Logan-Shi/Teleop-Hand/README.md

# Teleop-Hand
Designer and Manufacture 2 project
