Logan-Shi/Teleop-Hand/paper/README.md

### 指节自适应，弹簧+线驱动:   
> H. Luo, X. Duan and H. Deng, "Sliding mode impedance control of a underactuated prosthetic hand," 2014 IEEE International Conference on Information and Automation (ICIA), Hailar, 2014, pp. 726-729.

### 指节自适应，连杆:  
> J. Zhao, L. Jiang, S. Shi, H. Cai, H. Liu and G. Hirzinger, "A Five-fingered Underactuated Prosthetic Hand System," 2006 International Conference on Mechatronics and Automation, Luoyang, Henan, 2006, pp. 1453-1458.

### actuation有点复杂，不确定怎么实现的自适应，弹簧+线驱动:
> T. E. Wiste, S. A. Dalley, T. J. Withrow and M. Goldfarb, "Design of a multifunctional anthropomorphic prosthetic hand with extrinsic actuation," 2009 IEEE International Conference on Rehabilitation Robotics, Kyoto, 2009, pp. 675-681.

### RTR，手指间自适应，线驱动，具体机械结构没给，看上去用了齿轮:  
> Dario, Paolo & Carrozza, M & Menciassi, A & Micera, Silvestro & Zecca, Massimiliano & Cappiello, G & Sebastiani, F & Freschi, Cinzia & Scuola, Superiore & anna, Polo & Sant, & Viale, Anna & Piaggio, Rinaldo. (2019). On the development of a cybernetic hand prosthesis.
