Logan-Shi/Teleop-Hand/Meeting record.md

# 设计与制造会议记录 
#会议记录
## 2019.09.16
* 提出设计思路
> 垃圾分拣  
> 无人驾驶  
> 车辆底盘悬挂  
## 2019.09.23
* 继续讨论开题内容
> 垃圾分拣  
> 	通过深度神经网络识别垃圾类型，通过机械手分拣  
> 机械手  
> 	仿生机械手，通过rgbd相机识别对象手势，进行模拟和行为  
> 全地形车辆  
> 	利用可变形车轮实现全地形移动  
> 基于球形关节的三维建模设备	  
> 	实现难度集中在算法  
## 2019.10.08
> 确定项目工作场景：分拣抓取  
> 确定大致机械结构：  
> 	三指机械手，圆形手掌，其中一指根部固定，另外两指能够移动到固定/任意位置。即三指120º夹角或一指与另外两指180º夹角，来应对不同物体的抓取。  
> 当前工作重点：  
> 	**继续深入市场调研**  
> 		已有的材料是：目前大多数厂家应对机械臂抓取时采用的方案是，在应对	不同抓取场景时，更换不同的手指（类似于换刀）。  
> 	暂定可行的解释方案：  
> 		提高抓取效率  
> 	**机械结构设计**  
> 	两种手指位置转换时，手指根部的固定  
> 	单个手指的开合  
> 提出的可行扩展方案：  
> 	**加入自适应抓取手指结构**  
> 		可能可以借鉴螺旋测微器末端的机械结构，当单个指节遇到阻碍时，利用		棘轮停止该关节的继续转动，保护关节。同时设计某种传动机构，实现卡		住上一个关节的同时，继续操控下一关节  
> 将来可能要注意的事情：  
> 	**标准件的选取**  
> 		可以降低设计成本、便于更换  
> 当前分工：  
> 	石子康：应用场景的深入调研  
> 	隋思哲 董仕豪：手指根部位置转换和固定的机构调研和设计  
> 	梁锐彬 陈锦辉：手指开合关节的设计  
>    
> 目前已完成工作：  
> 视觉部分：  
> 	已经找到可用的手势识别api，可以识别各个关节对应的角度
