Logan-Shi/Teleop-Hand/机械手3.9.4_Szk_even_more装配裕量/手指2.1/零件清单.xlsx

名称 | 数量 | 制作方式
根指节 | 3 | 3D打印
尾指节 | 3 | 3D打印
拇指跟 | 1 | 3D打印
手指跟 | 2 | 3D打印
顶盖走线 | 1 | 3D打印
钢轴phi3 | 3 | 购买
钢轴phi5 | 3 | 购买
推力轴承5*12*4 | 6 | 购买
轴承3*7*3 | 12 | 购买
轴承2*5*2.5 | 2 | 购买
扭簧 | 3 | 购买
拉伸弹簧 | 3 | 购买
