Logan-Shi/Teleop-Hand/机械手3.9.4_Szk_even_more装配裕量/底座/block_b3.SLDASM

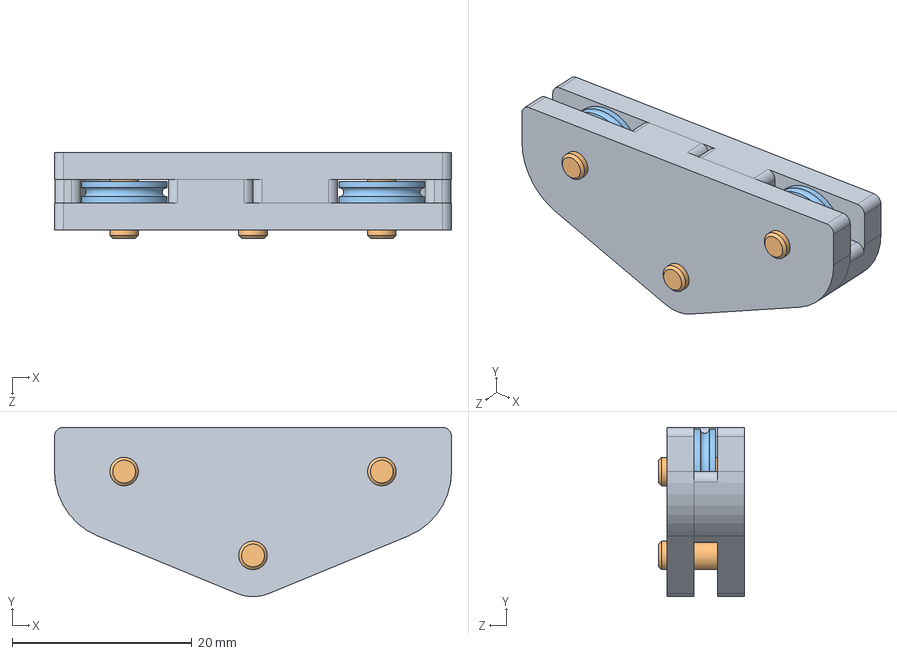
[picture p20: CAD file, 2019-12-19]
机械手3.9.4_Szk_even_more装配裕量/底座/block_b3.SLDASM
44.2 x 18.9 x 9.53 mm
b3_t x 2
97395A435 D1-8 L3-8 x 3
3434T31 - nylon pulley x 2
