Logan-Shi/Teleop-Hand/机械手3.9.4_Szk_even_more装配裕量/手指2.1/手指.SLDASM

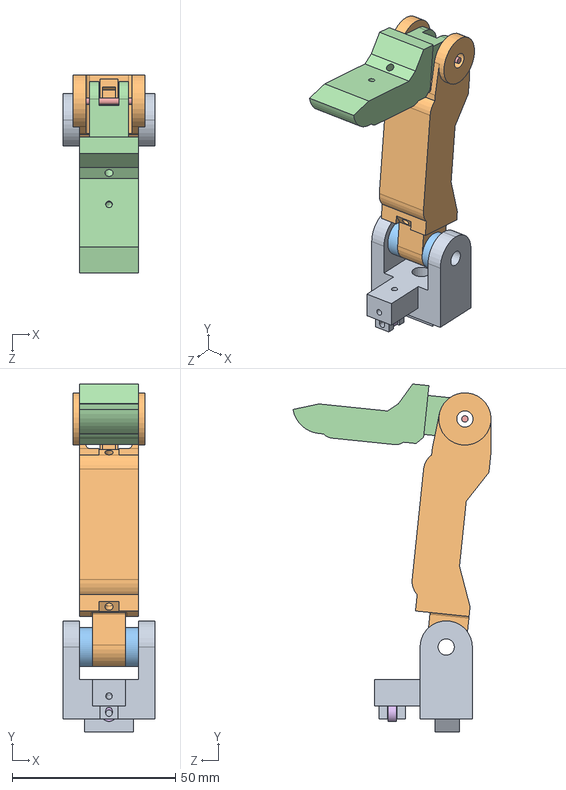
[picture p21: CAD file, 2019-12-19]
机械手3.9.4_Szk_even_more装配裕量/手指2.1/手指.SLDASM
28.0 x 106.5 x 60.6 mm
手指根
根指节
推力轴承 x 2
尾指节
转轴
小轴承
