Logan-Shi/Teleop-Hand/机械手3.9.4_Szk_even_more装配裕量/机械手总装.SLDASM

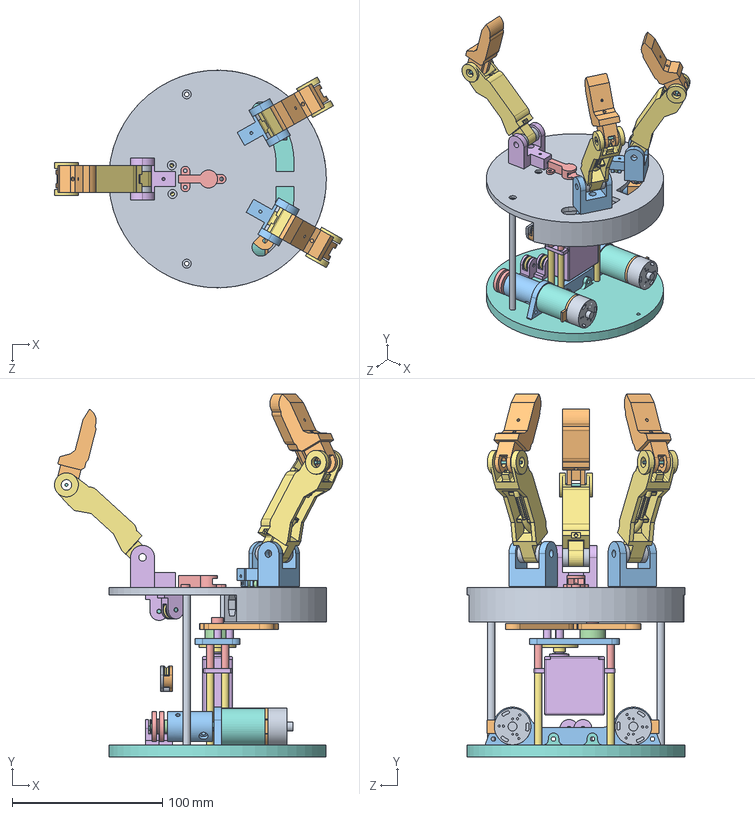
[picture p22: CAD file, 2019-12-19]
机械手3.9.4_Szk_even_more装配裕量/机械手总装.SLDASM
191.9 x 241.9 x 145.0 mm
底座2.0
滑块 x 2
轴承 x 8
铝柱8mm x 2
推力轴承3-8-4 x 3
小舵机
舵盘
圆形底座
铝柱60mm x 2
圆柱齿轮22×1 x 2
支撑板
推力轴承7-17-6
铝柱16mm x 4
铝柱10mm x 3
铝柱48 x 4
新版2006电机头 x 2
新版2006电机尾 x 2
新版2006电机腰 x 2
电机连接件 x 2
棘轮 x 2
棘轮连接件 x 2
拇指根
根指节 x 3
转轴 x 3
推力轴承 x 6
尾指节 x 3
手指根 x 2
小轴承 x 2
stand_5 x 5
pulley x 7
axis x 7
diff_brick_1
电机固定板
