Logan-Shi/Teleop-Hand/机械手3.9.4_Szk_even_more装配裕量/底座/舵机传动.SLDASM

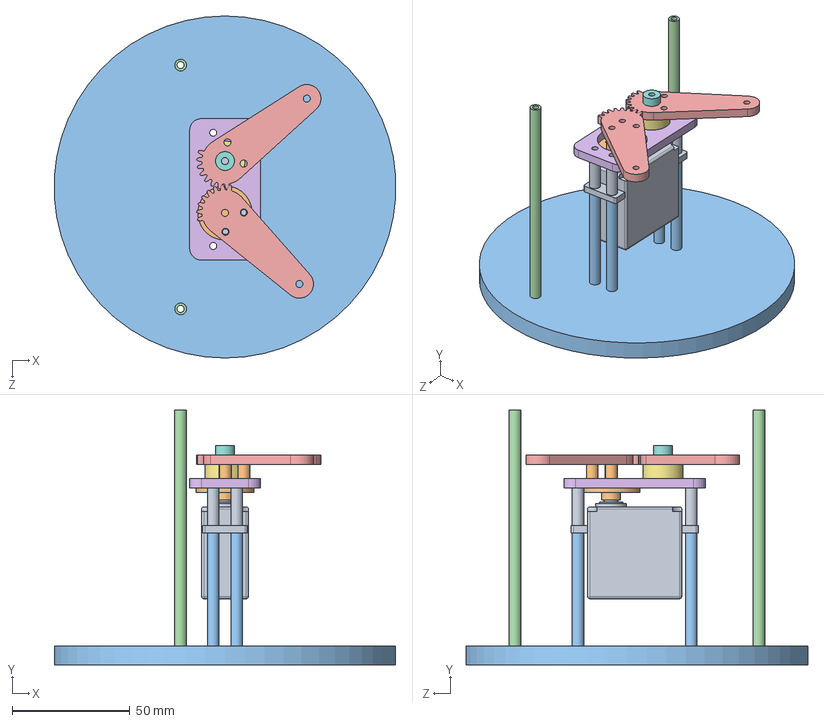
[picture p23: CAD file, 2019-12-19]
机械手3.9.4_Szk_even_more装配裕量/底座/舵机传动.SLDASM
144.8 x 108.0 x 145.0 mm
小舵机
舵盘
圆形底座
铝柱60mm x 2
圆柱齿轮22×1 x 2
支撑板
推力轴承7-17-6
推力轴承3-8-4
铝柱16mm x 4
铝柱10mm x 3
铝柱48 x 4
