Logan-Shi/Teleop-Hand/机械手3.9.4_Szk_even_more装配裕量/走线装置/导引机构.SLDASM

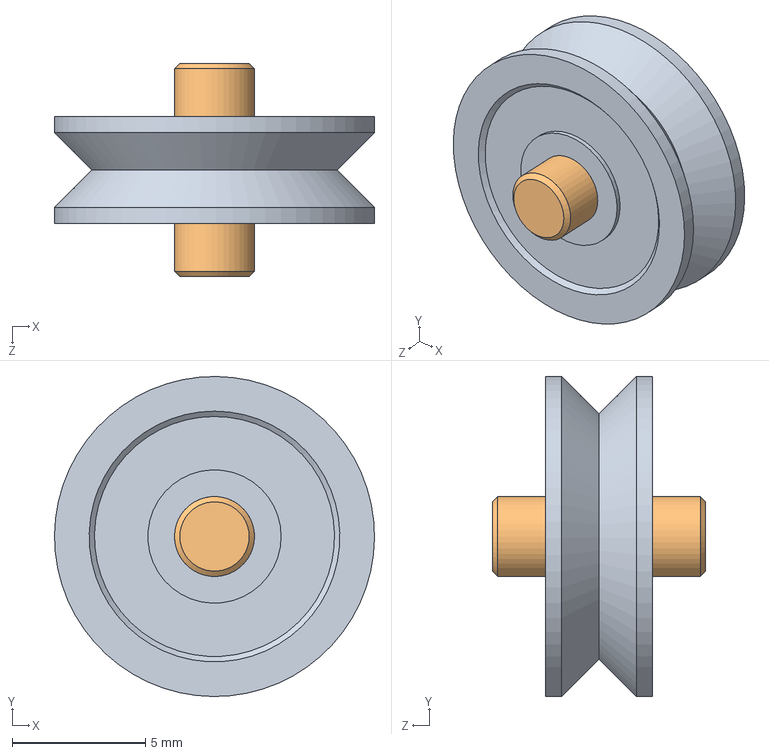
[picture p24: CAD file, 2019-12-19]
机械手3.9.4_Szk_even_more装配裕量/走线装置/导引机构.SLDASM
12.0 x 12.0 x 8.00 mm
pulley
axis
