Logan-Shi/Teleop-Hand/机械手3.9.4_Szk_even_more装配裕量/电机/新版2006电机棘轮.SLDASM

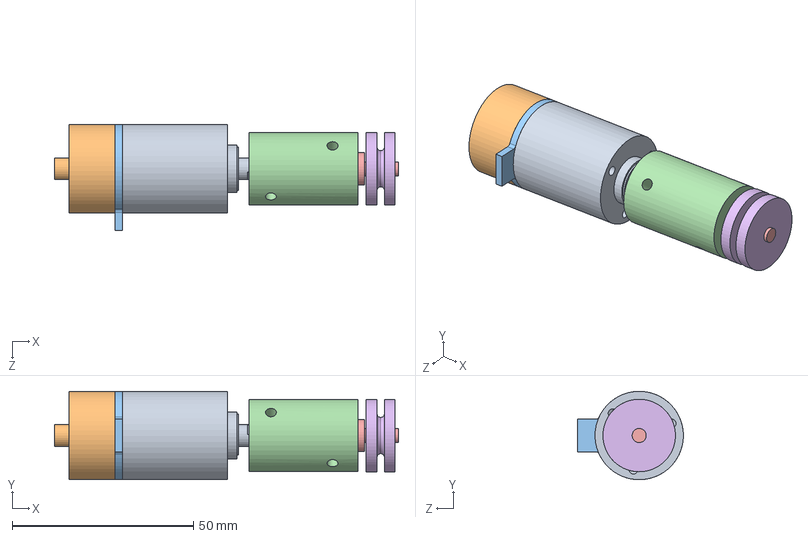
[picture p25: CAD file, 2019-12-19]
机械手3.9.4_Szk_even_more装配裕量/电机/新版2006电机棘轮.SLDASM
94.9 x 24.4 x 29.2 mm
新版2006电机头
新版2006电机尾
新版2006电机腰
电机连接件
棘轮
棘轮连接件
