Logan-Shi/Teleop-Hand/机械手3.9.4_Szk_even_more装配裕量/走线装置/差分机构.SLDASM

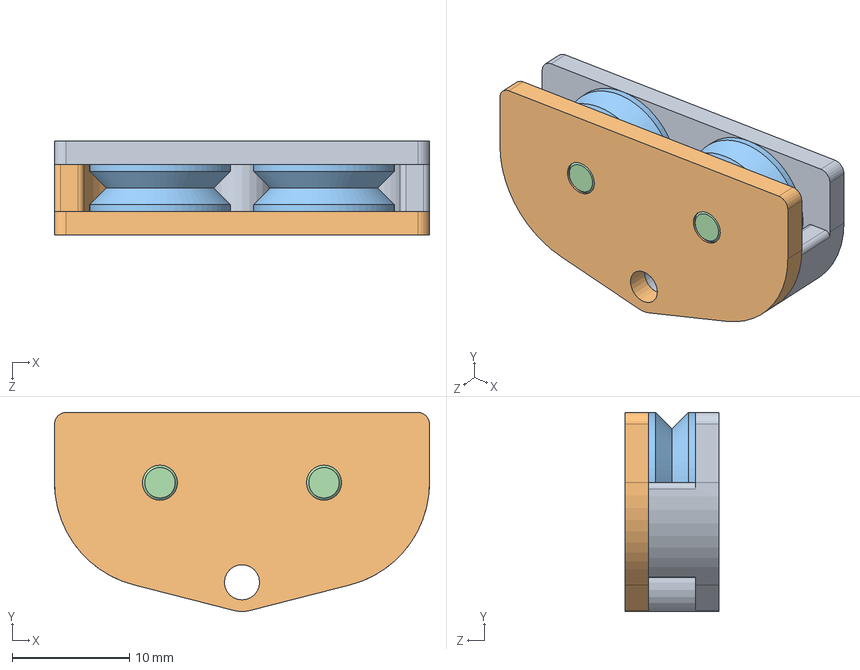
[picture p26: CAD file, 2019-12-19]
机械手3.9.4_Szk_even_more装配裕量/走线装置/差分机构.SLDASM
32.0 x 17.0 x 8.00 mm
diff_brick_1
diff_brick_2
pulley x 2
axis x 2
