Logan-Shi/Teleop-Hand/机械手3.9.4_Szk_even_more装配裕量/底座/小滑块.SLDASM

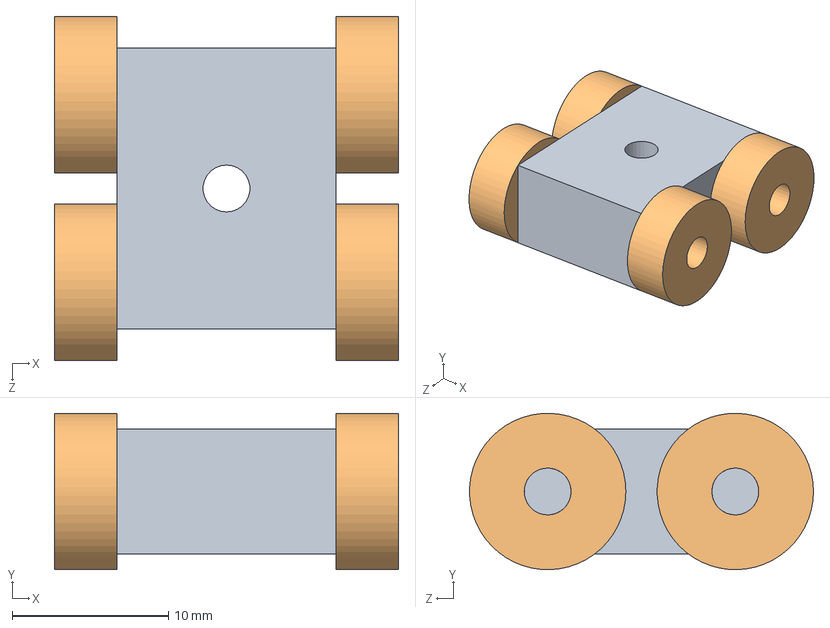
[picture p27: CAD file, 2019-12-19]
机械手3.9.4_Szk_even_more装配裕量/底座/小滑块.SLDASM
22.0 x 10.00 x 22.0 mm
滑块
轴承 x 4
