Logan-Shi/Teleop-Hand/机械手3.9.4_Szk_even_more装配裕量/手指2.1/拇指.SLDASM

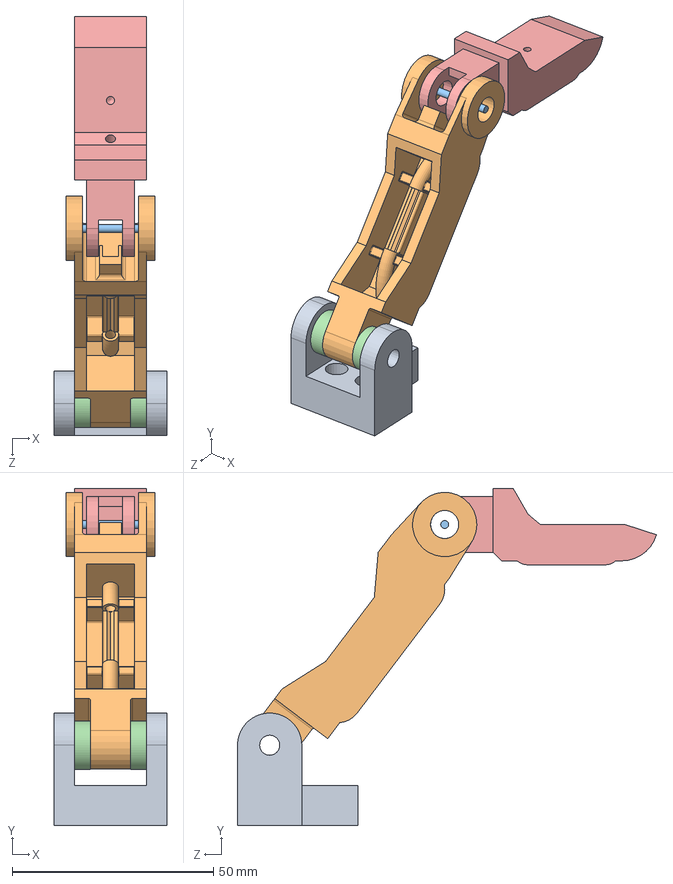
[picture p29: CAD file, 2019-12-19]
机械手3.9.4_Szk_even_more装配裕量/手指2.1/拇指.SLDASM
28.0 x 83.9 x 104.1 mm
拇指根
根指节
转轴
推力轴承 x 2
尾指节
