Logan-Shi/Teleop-Hand/机械手3.9.4_Szk_even_more装配裕量/底座/齿轮.SLDASM

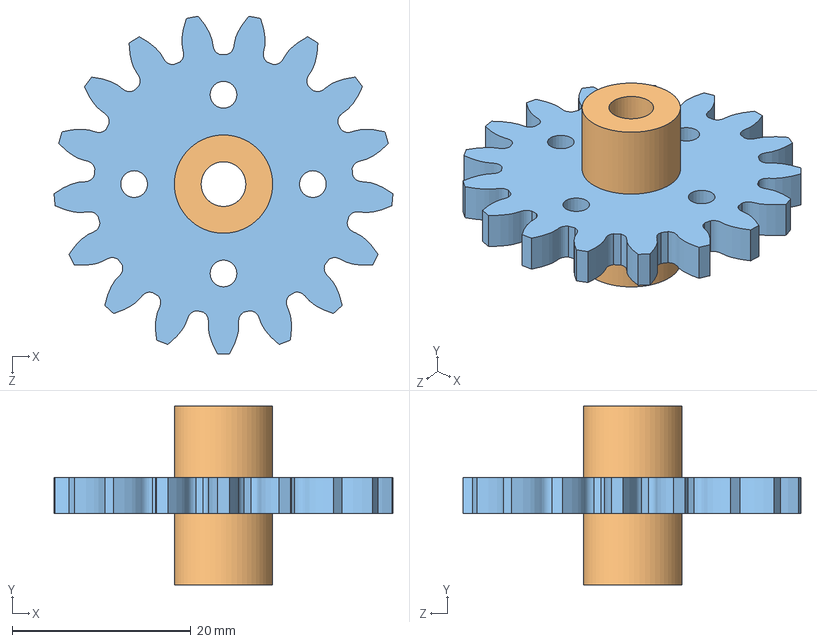
[picture p30: CAD file, 2019-12-19]
机械手3.9.4_Szk_even_more装配裕量/底座/齿轮.SLDASM
37.9 x 20.0 x 37.8 mm
轴承5-10-4
紧固环5-11-8 x 2
圆柱齿轮17×2
