Logan-Shi/Teleop-Hand/机械手3.9.4_Szk_even_more装配裕量/手指2.1/打印件/尾指节.STL

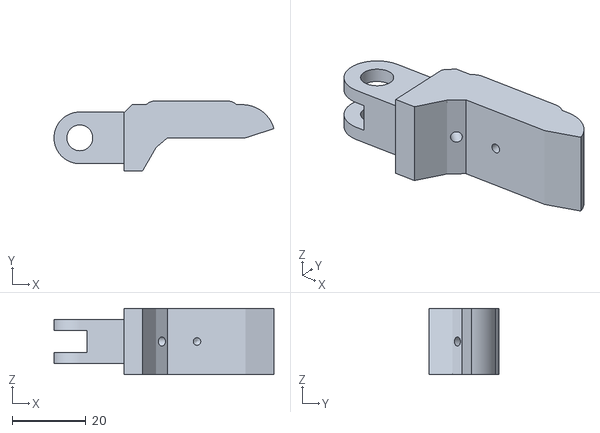
[picture p31: CAD file, 2019-12-19]
机械手3.9.4_Szk_even_more装配裕量/手指2.1/打印件/尾指节.STL
59.6 x 19.0 x 18.0
