Logan-Shi/Teleop-Hand/机械手3.9.4_Szk_even_more装配裕量/手指2.1/根指节.SLDPRT

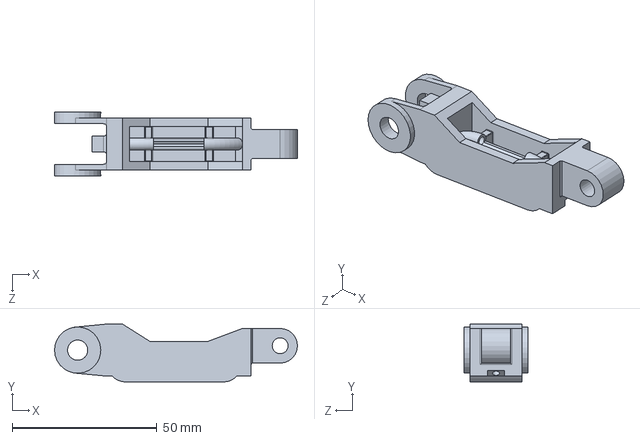
[picture p32: CAD file, 2019-12-19]
机械手3.9.4_Szk_even_more装配裕量/手指2.1/根指节.SLDPRT
84.0 x 20.0 x 22.0 mm
