Logan-Shi/Teleop-Hand/机械手3.9.4_Szk_even_more装配裕量/电机/新版2006电机尾.SLDPRT

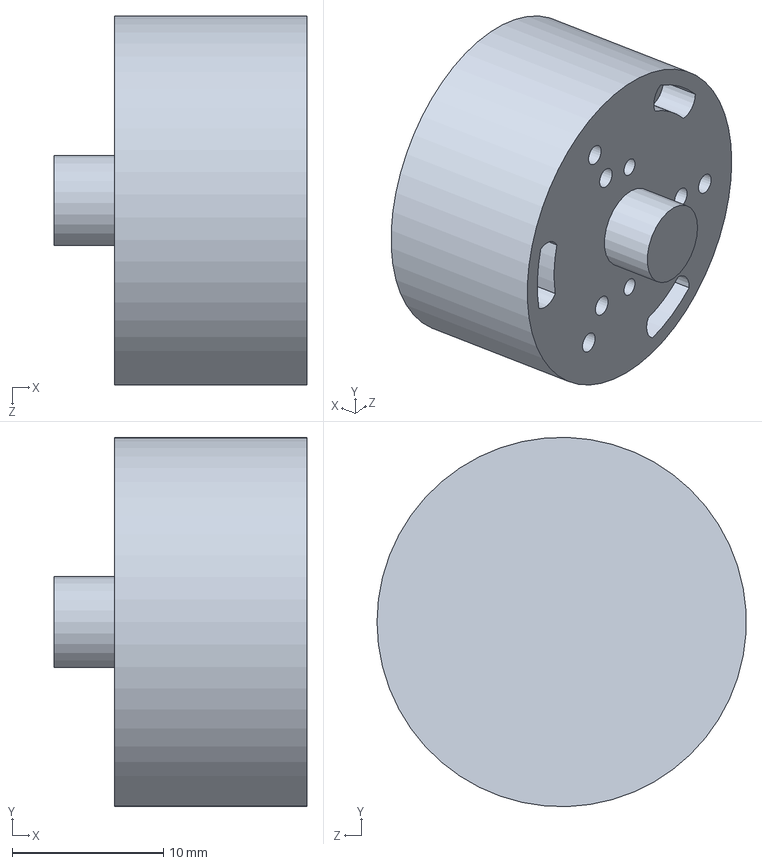
[picture p33: CAD file, 2019-12-19]
机械手3.9.4_Szk_even_more装配裕量/电机/新版2006电机尾.SLDPRT
16.7 x 24.4 x 24.4 mm
