Logan-Shi/Teleop-Hand/机械手3.9.4_Szk_even_more装配裕量/走线装置/diff_brick_2.SLDPRT

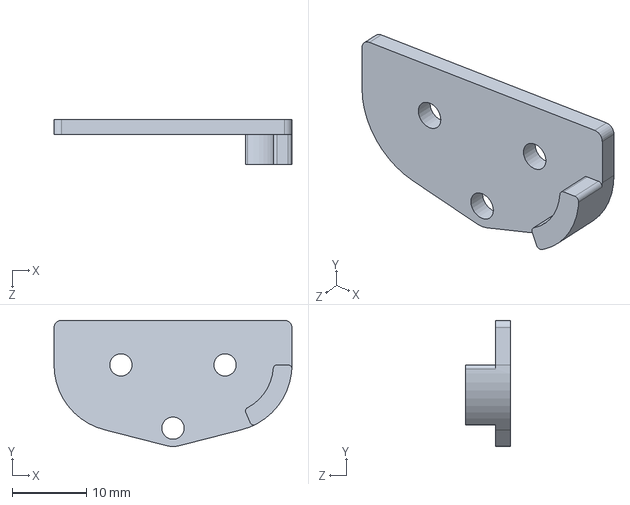
[picture p34: CAD file, 2019-12-19]
机械手3.9.4_Szk_even_more装配裕量/走线装置/diff_brick_2.SLDPRT
32.0 x 17.0 x 6.00 mm
