Logan-Shi/Teleop-Hand/机械手3.9.4_Szk_even_more装配裕量/顶盖走线.SLDPRT

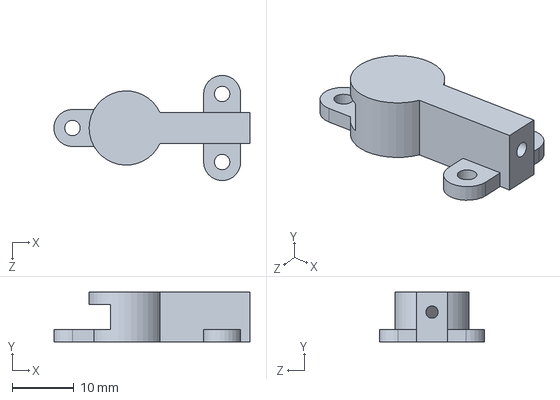
[picture p35: CAD file, 2019-12-19]
机械手3.9.4_Szk_even_more装配裕量/顶盖走线.SLDPRT
31.7 x 8.00 x 17.0 mm
