Logan-Shi/Teleop-Hand/机械手3.9.4_Szk_even_more装配裕量/底座/圆柱齿轮17×2.SLDPRT

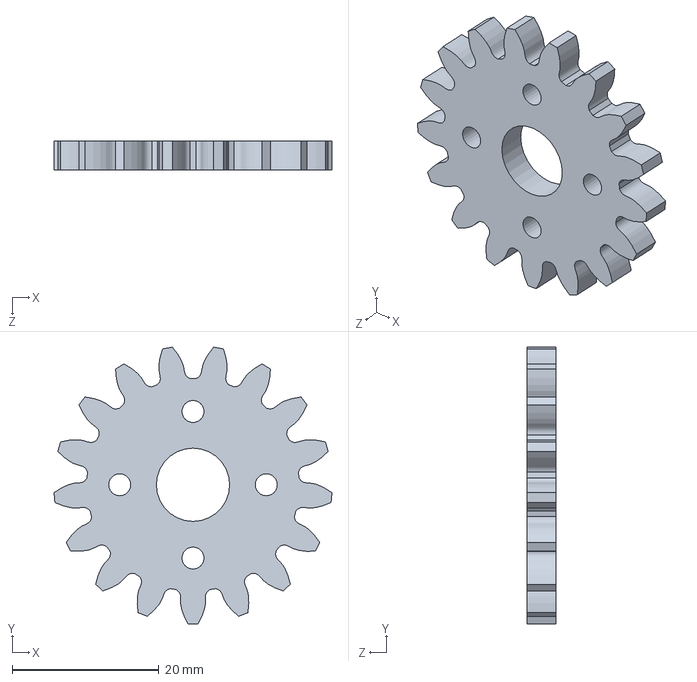
[picture p36: CAD file, 2019-12-19]
机械手3.9.4_Szk_even_more装配裕量/底座/圆柱齿轮17×2.SLDPRT
37.9 x 37.8 x 4.00 mm
