Logan-Shi/Teleop-Hand/机械手3.9.4_Szk_even_more装配裕量/电机/电机固定板.SLDPRT

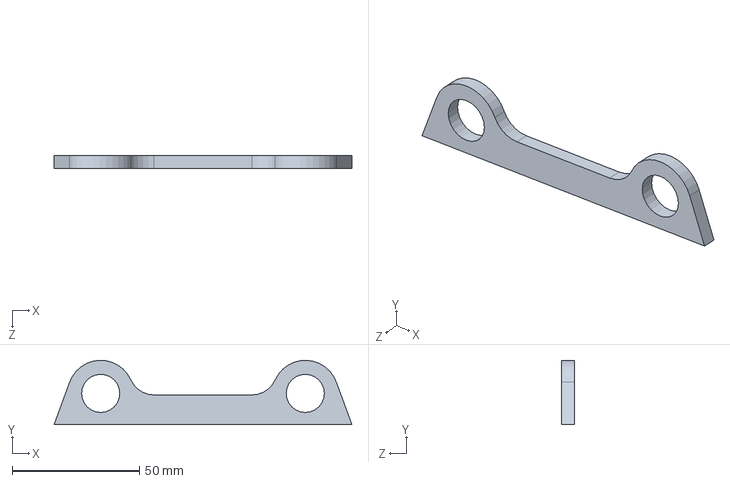
[picture p37: CAD file, 2019-12-19]
机械手3.9.4_Szk_even_more装配裕量/电机/电机固定板.SLDPRT
117.2 x 25.3 x 5.00 mm
