Logan-Shi/Teleop-Hand/机械手3.9.4_Szk_even_more装配裕量/走线装置/pulley.SLDPRT

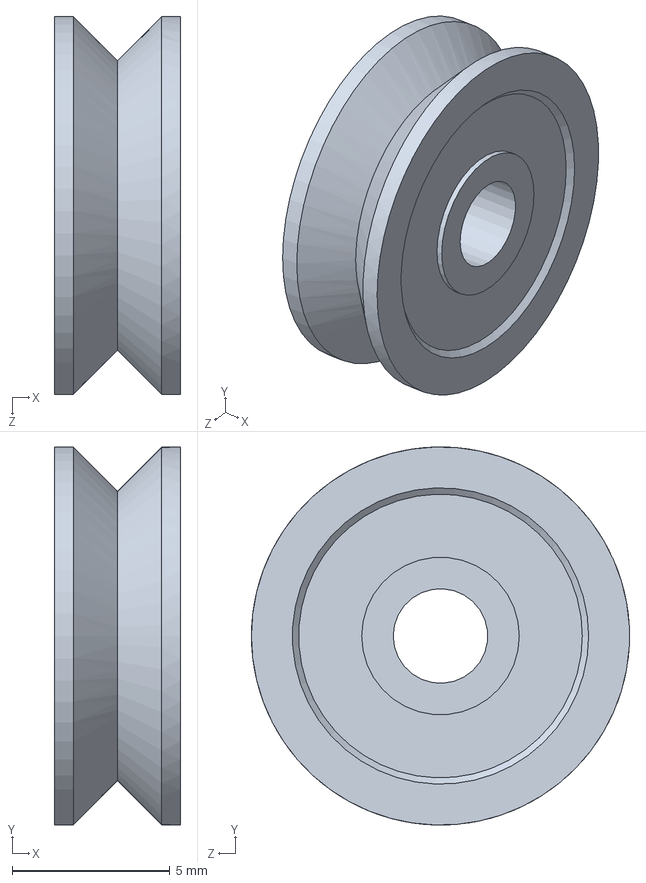
[picture p38: CAD file, 2019-12-19]
机械手3.9.4_Szk_even_more装配裕量/走线装置/pulley.SLDPRT
4.00 x 12.0 x 12.0 mm
