Logan-Shi/Teleop-Hand/机械手3.9.4_Szk_even_more装配裕量/底座/b3_t.SLDPRT

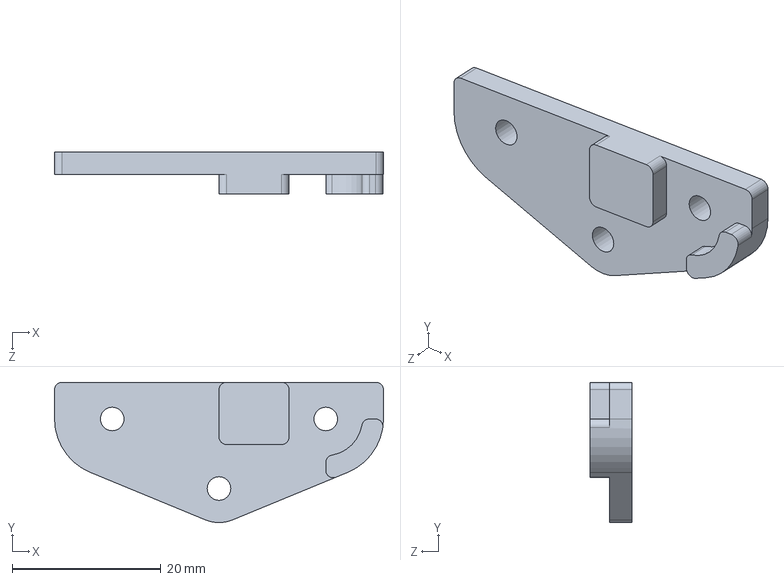
[picture p39: CAD file, 2019-12-19]
机械手3.9.4_Szk_even_more装配裕量/底座/b3_t.SLDPRT
44.2 x 18.9 x 5.57 mm
