Logan-Shi/Teleop-Hand/机械手3.9.4_Szk_even_more装配裕量/手指2.1/拇指根.SLDPRT

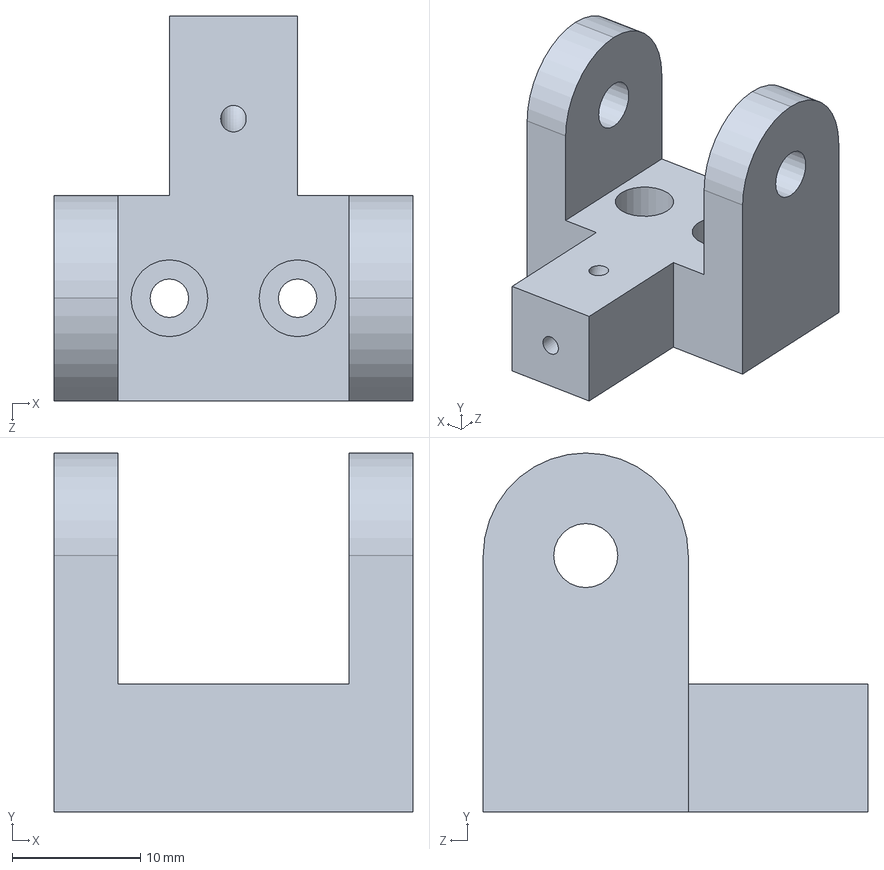
[picture p40: CAD file, 2019-12-19]
机械手3.9.4_Szk_even_more装配裕量/手指2.1/拇指根.SLDPRT
28.0 x 28.0 x 30.0 mm
