Logan-Shi/Teleop-Hand/机械手3.9.4_Szk_even_more装配裕量/电机/新版2006电机头.SLDPRT

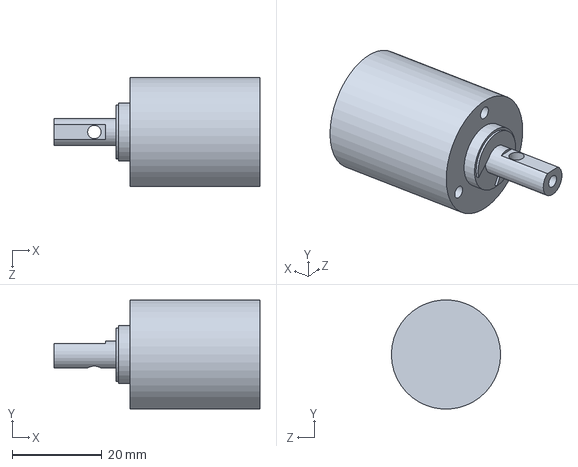
[picture p41: CAD file, 2019-12-19]
机械手3.9.4_Szk_even_more装配裕量/电机/新版2006电机头.SLDPRT
46.0 x 24.3 x 24.4 mm
