Logan-Shi/Teleop-Hand/机械手3.9.4_Szk_even_more装配裕量/走线装置/axis.SLDPRT

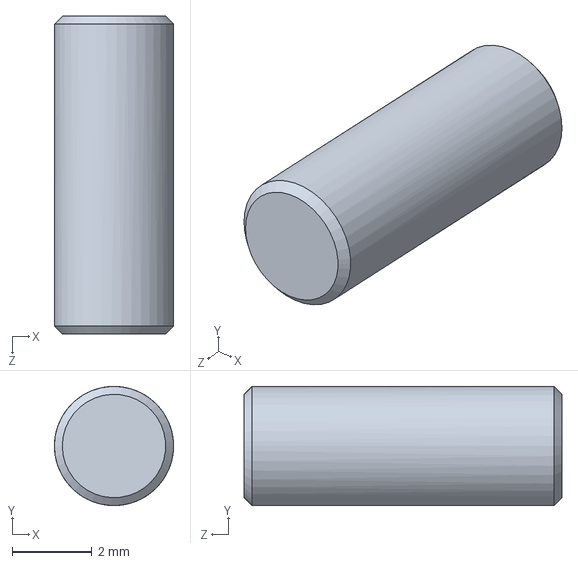
[picture p42: CAD file, 2019-12-19]
机械手3.9.4_Szk_even_more装配裕量/走线装置/axis.SLDPRT
3.00 x 3.00 x 8.00 mm
