Logan-Shi/Teleop-Hand/机械手3.9.4_Szk_even_more装配裕量/底座/b5_t.SLDPRT

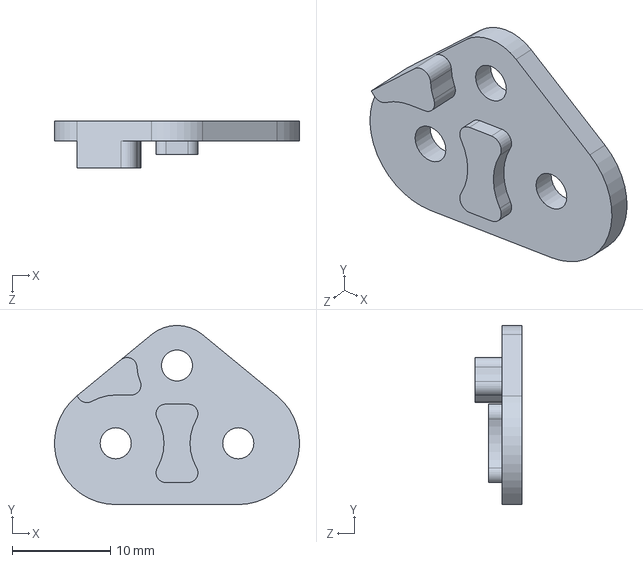
[picture p43: CAD file, 2019-12-19]
机械手3.9.4_Szk_even_more装配裕量/底座/b5_t.SLDPRT
25.0 x 18.3 x 4.75 mm
