Logan-Shi/Teleop-Hand/机械手3.9.4_Szk_even_more装配裕量/手指2.1/扭簧.SLDPRT

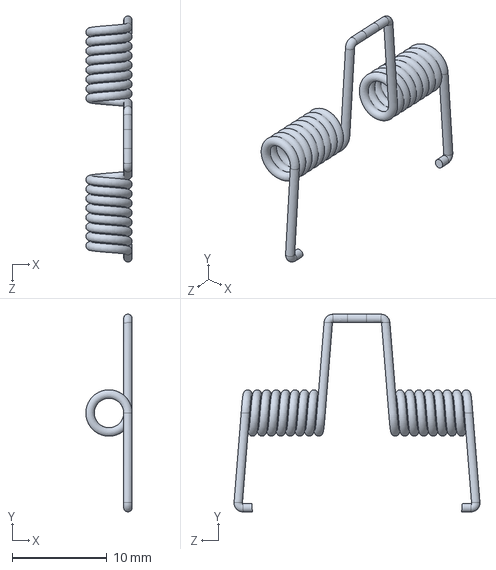
[picture p44: CAD file, 2019-12-19]
机械手3.9.4_Szk_even_more装配裕量/手指2.1/扭簧.SLDPRT
4.90 x 20.9 x 26.0 mm
