Logan-Shi/Teleop-Hand/机械手3.9.4_Szk_even_more装配裕量/电机/棘轮连接件.SLDPRT

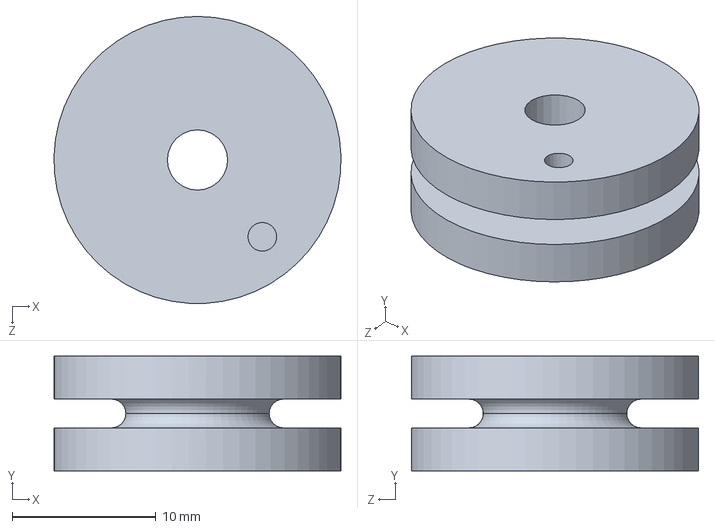
[picture p45: CAD file, 2019-12-19]
机械手3.9.4_Szk_even_more装配裕量/电机/棘轮连接件.SLDPRT
20.0 x 8.00 x 20.0 mm
