Logan-Shi/Teleop-Hand/机械手3.9.4_Szk_even_more装配裕量/底座/圆柱齿轮22×1.SLDPRT

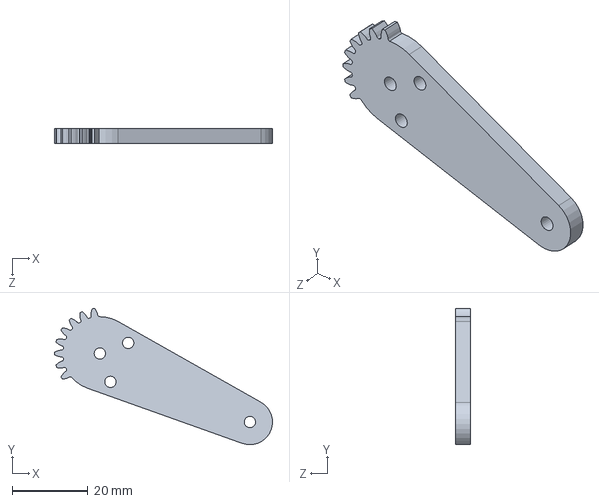
[picture p46: CAD file, 2019-12-19]
机械手3.9.4_Szk_even_more装配裕量/底座/圆柱齿轮22×1.SLDPRT
57.7 x 36.0 x 4.00 mm
