Logan-Shi/Teleop-Hand/机械手3.9.4_Szk_even_more装配裕量/手指2.1/根指节盖.SLDPRT

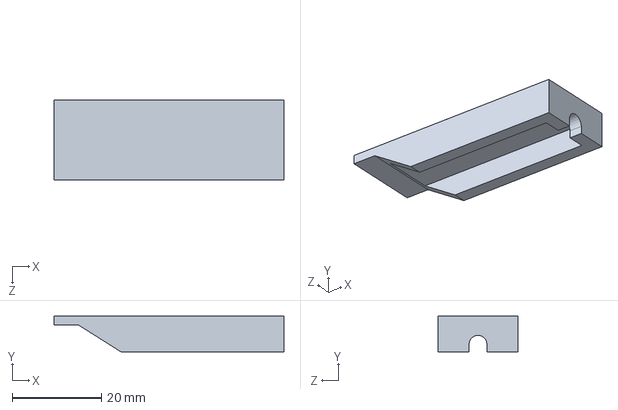
[picture p47: CAD file, 2019-12-19]
机械手3.9.4_Szk_even_more装配裕量/手指2.1/根指节盖.SLDPRT
51.5 x 8.00 x 18.0 mm
