Logan-Shi/Teleop-Hand/机械手3.9.4_Szk_even_more装配裕量/电机/新版2006电机腰.SLDPRT

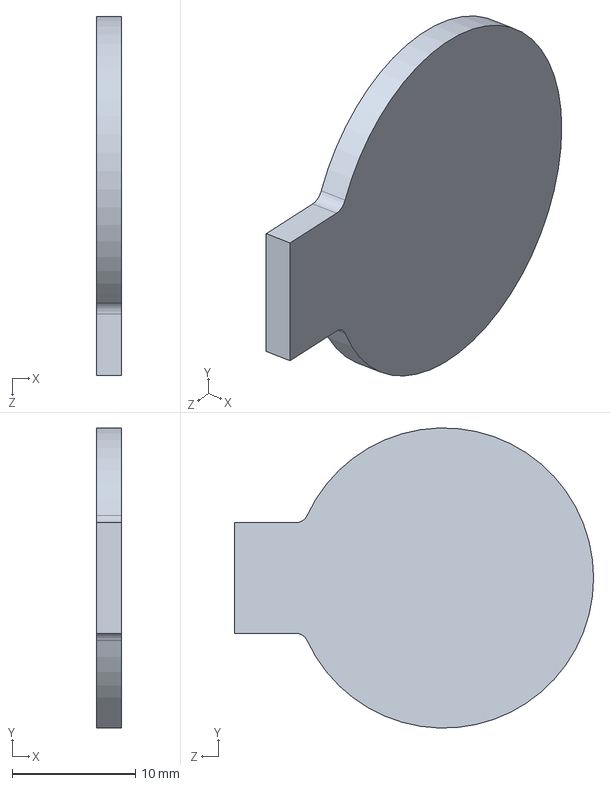
[picture p48: CAD file, 2019-12-19]
机械手3.9.4_Szk_even_more装配裕量/电机/新版2006电机腰.SLDPRT
2.00 x 24.4 x 29.2 mm
