Logan-Shi/Teleop-Hand/机械手3.9.4_Szk_even_more装配裕量/走线装置/bearing_stand.SLDPRT

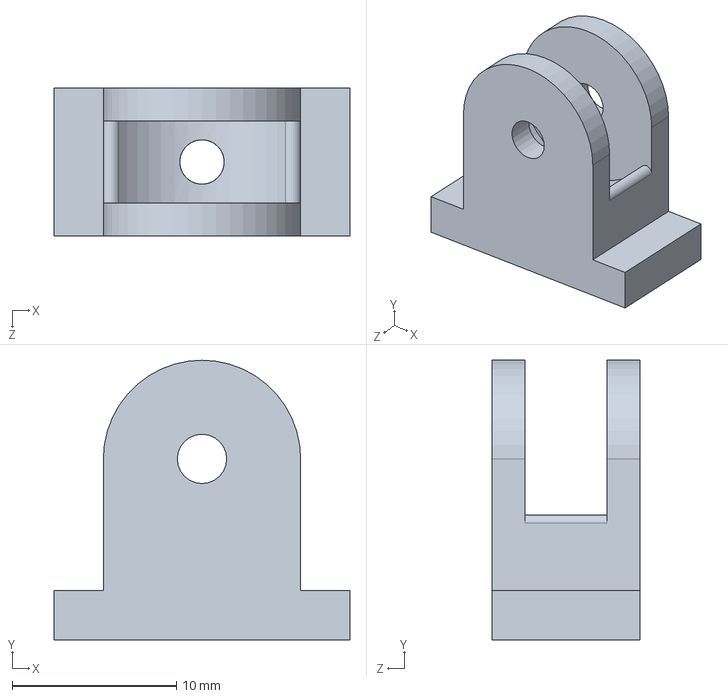
[picture p49: CAD file, 2019-12-19]
机械手3.9.4_Szk_even_more装配裕量/走线装置/bearing_stand.SLDPRT
18.0 x 17.0 x 9.00 mm
