Logan-Shi/Teleop-Hand/机械手3.9.4_Szk_even_more装配裕量/手指2.1/小轴承.SLDPRT

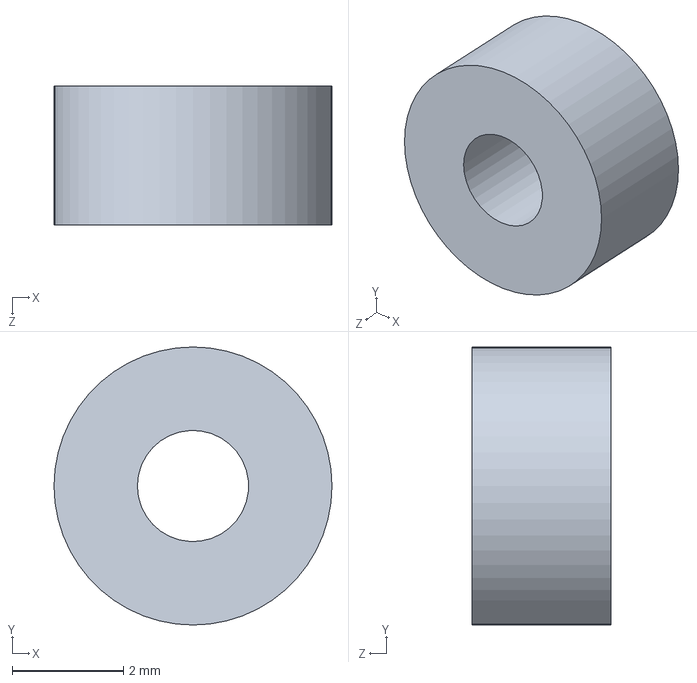
[picture p50: CAD file, 2019-12-19]
机械手3.9.4_Szk_even_more装配裕量/手指2.1/小轴承.SLDPRT
5.00 x 5.00 x 2.50 mm
