Logan-Shi/Teleop-Hand/机械手3.9.4_Szk_even_more装配裕量/电机/棘轮.SLDPRT

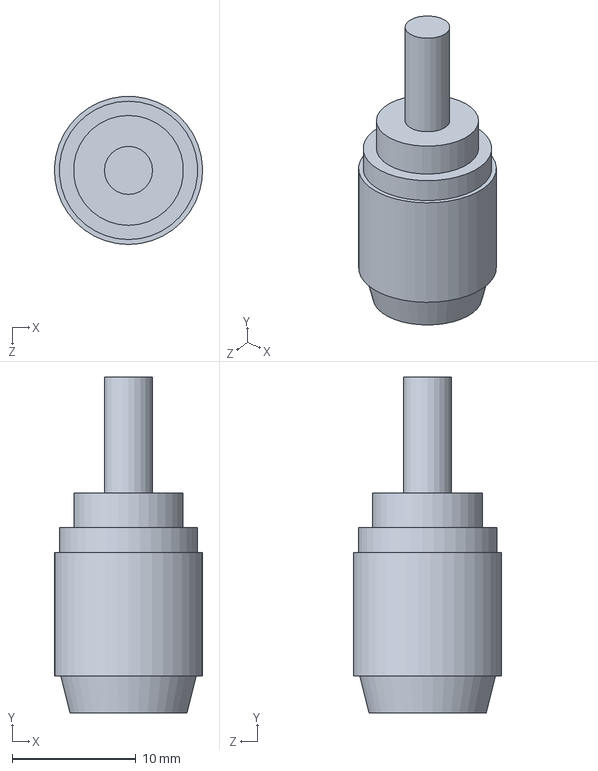
[picture p51: CAD file, 2019-12-19]
机械手3.9.4_Szk_even_more装配裕量/电机/棘轮.SLDPRT
12.0 x 27.2 x 12.0 mm
