Logan-Shi/Teleop-Hand/机械手3.9.4_Szk_even_more装配裕量/底座/底座2.0.SLDPRT

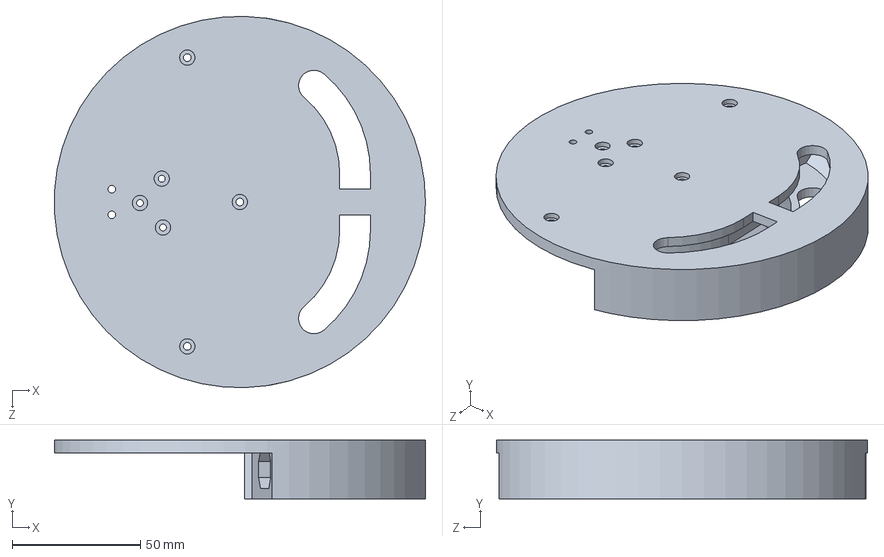
[picture p52: CAD file, 2019-12-19]
机械手3.9.4_Szk_even_more装配裕量/底座/底座2.0.SLDPRT
144.9 x 23.0 x 144.9 mm
