Logan-Shi/Teleop-Hand/机械手3.9.4_Szk_even_more装配裕量/底座/轴承5-10-4.SLDPRT

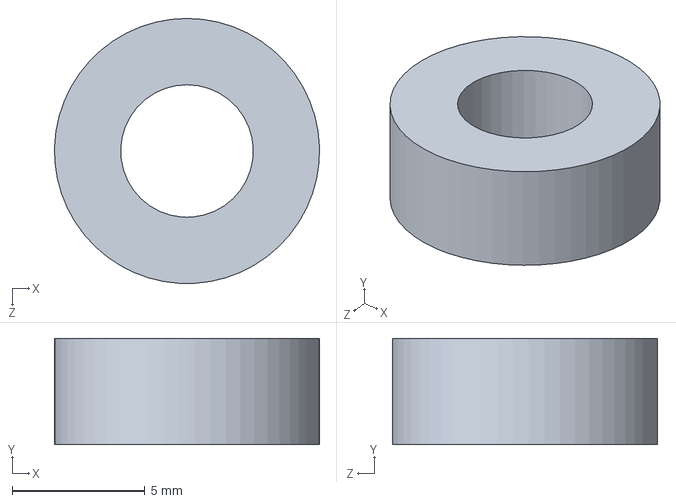
[picture p55: CAD file, 2019-12-19]
机械手3.9.4_Szk_even_more装配裕量/底座/轴承5-10-4.SLDPRT
10.00 x 4.00 x 10.0 mm
