Logan-Shi/Teleop-Hand/机械手3.9.4_Szk_even_more装配裕量/手指2.1/手指走线.SLDPRT

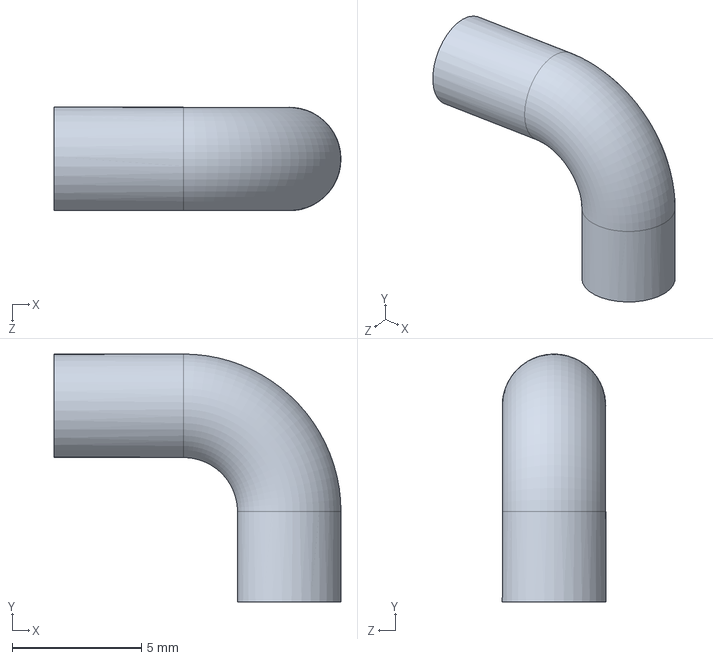
[picture p56: CAD file, 2019-12-19]
机械手3.9.4_Szk_even_more装配裕量/手指2.1/手指走线.SLDPRT
11.1 x 9.58 x 4.00 mm
