Logan-Shi/Teleop-Hand/机械手3.9.4_Szk_even_more装配裕量/电机/电机连接件.SLDPRT

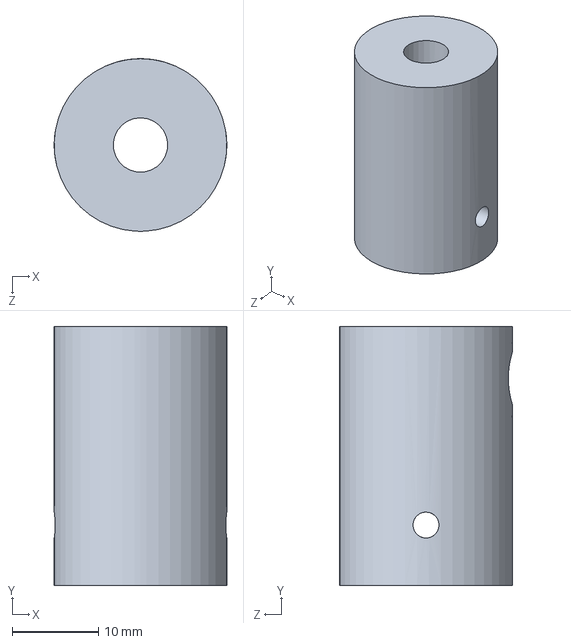
[picture p57: CAD file, 2019-12-19]
机械手3.9.4_Szk_even_more装配裕量/电机/电机连接件.SLDPRT
20.0 x 30.0 x 20.0 mm
