Logan-Shi/Teleop-Hand/机械手3.9.4_Szk_even_more装配裕量/底座/半臂舵盘.SLDPRT

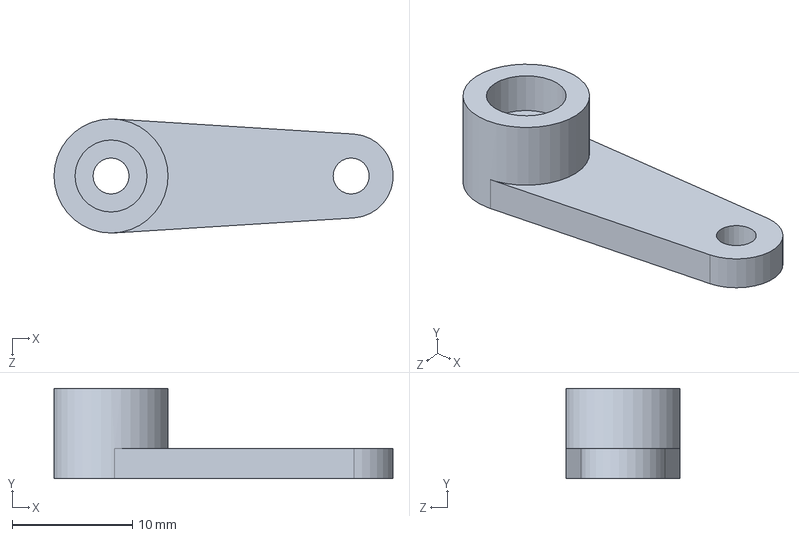
[picture p58: CAD file, 2019-12-19]
机械手3.9.4_Szk_even_more装配裕量/底座/半臂舵盘.SLDPRT
28.2 x 7.50 x 9.50 mm
