Logan-Shi/Teleop-Hand/机械手3.9.4_Szk_even_more装配裕量/手指2.1/扭簧2.SLDPRT

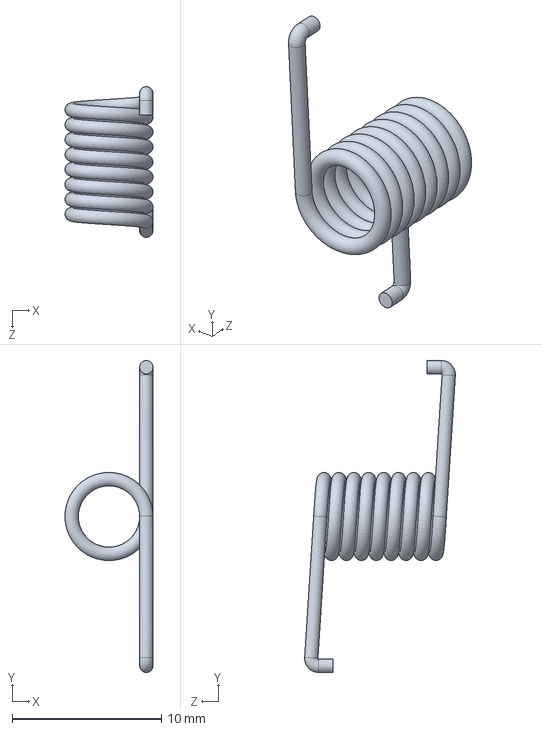
[picture p59: CAD file, 2019-12-19]
机械手3.9.4_Szk_even_more装配裕量/手指2.1/扭簧2.SLDPRT
5.90 x 20.9 x 10.1 mm
