Logan-Shi/Teleop-Hand/机械手3.9.4_Szk_even_more装配裕量/手指2.1/推力轴承.SLDPRT

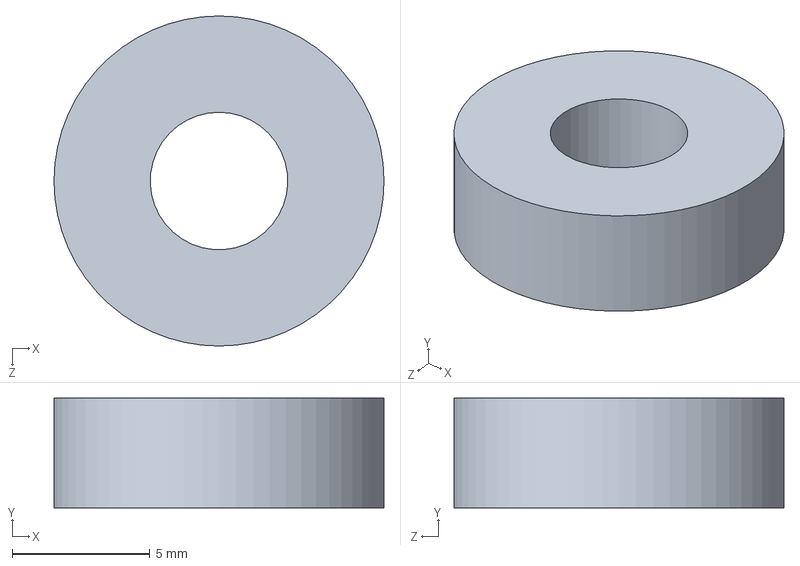
[picture p61: CAD file, 2019-12-19]
机械手3.9.4_Szk_even_more装配裕量/手指2.1/推力轴承.SLDPRT
12.0 x 4.00 x 12.0 mm
