Logan-Shi/Teleop-Hand/机械手3.9.4_Szk_even_more装配裕量/底座/支撑板.SLDPRT

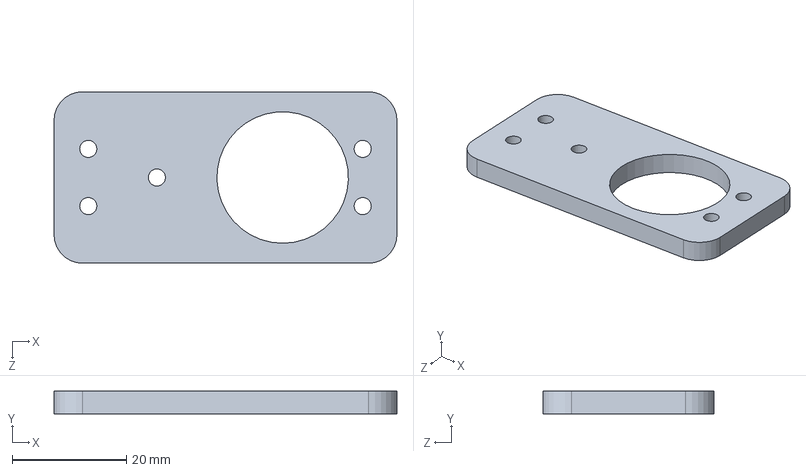
[picture p62: CAD file, 2019-12-19]
机械手3.9.4_Szk_even_more装配裕量/底座/支撑板.SLDPRT
60.0 x 4.00 x 30.0 mm
