Logan-Shi/Teleop-Hand/机械手3.9.4_Szk_even_more装配裕量/手指2.1/转轴.SLDPRT

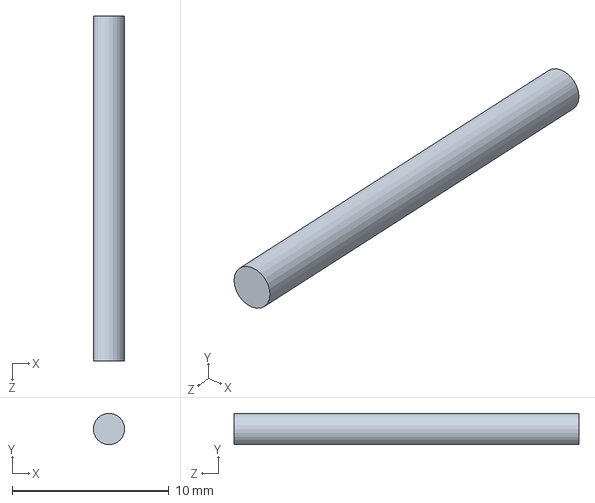
[picture p63: CAD file, 2019-12-19]
机械手3.9.4_Szk_even_more装配裕量/手指2.1/转轴.SLDPRT
2.00 x 2.00 x 22.0 mm
