Logan-Shi/Teleop-Hand/机械手3.9.4_Szk_even_more装配裕量/底座/铝柱10mm.SLDPRT

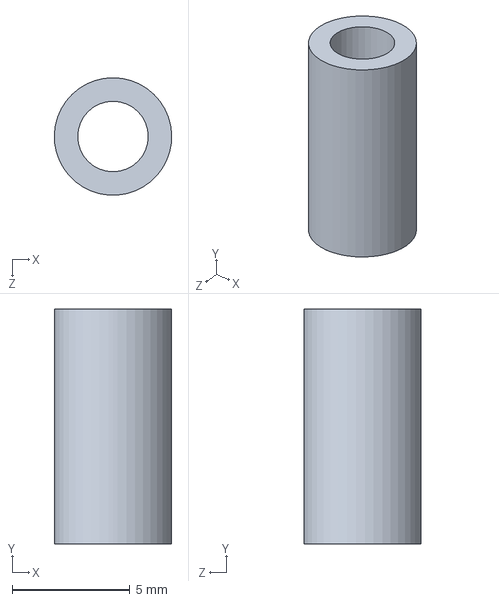
[picture p67: CAD file, 2019-12-19]
机械手3.9.4_Szk_even_more装配裕量/底座/铝柱10mm.SLDPRT
5.00 x 10.0 x 5.00 mm
