Logan-Shi/Teleop-Hand/机械手3.9.4_Szk_even_more装配裕量/底座/小舵机.SLDPRT

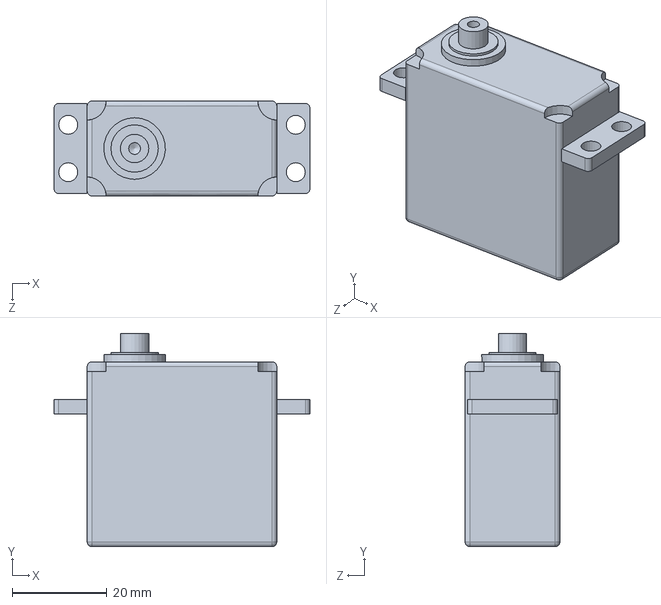
[picture p68: CAD file, 2019-12-19]
机械手3.9.4_Szk_even_more装配裕量/底座/小舵机.SLDPRT
54.0 x 45.0 x 20.0 mm
