Logan-Shi/Teleop-Hand/机械手3.9.4_Szk_even_more装配裕量/底座/传动杆.SLDPRT

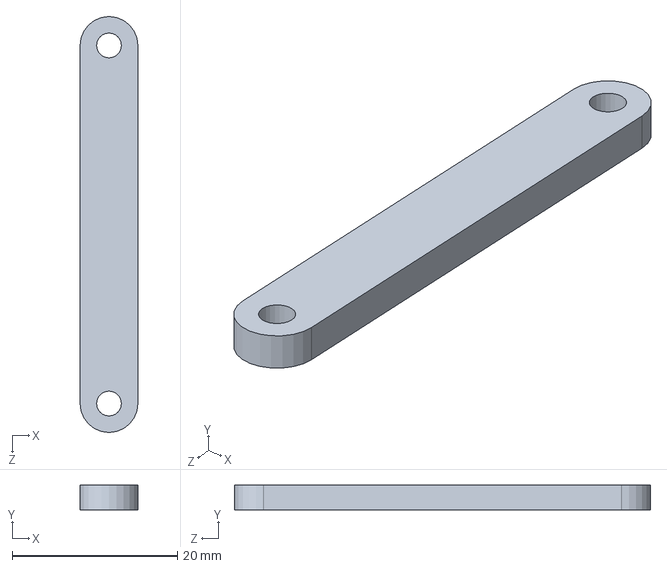
[picture p69: CAD file, 2019-12-19]
机械手3.9.4_Szk_even_more装配裕量/底座/传动杆.SLDPRT
7.00 x 3.00 x 50.3 mm
