Logan-Shi/Teleop-Hand/机械手3.9.4_Szk_even_more装配裕量/底座/壳子.SLDPRT

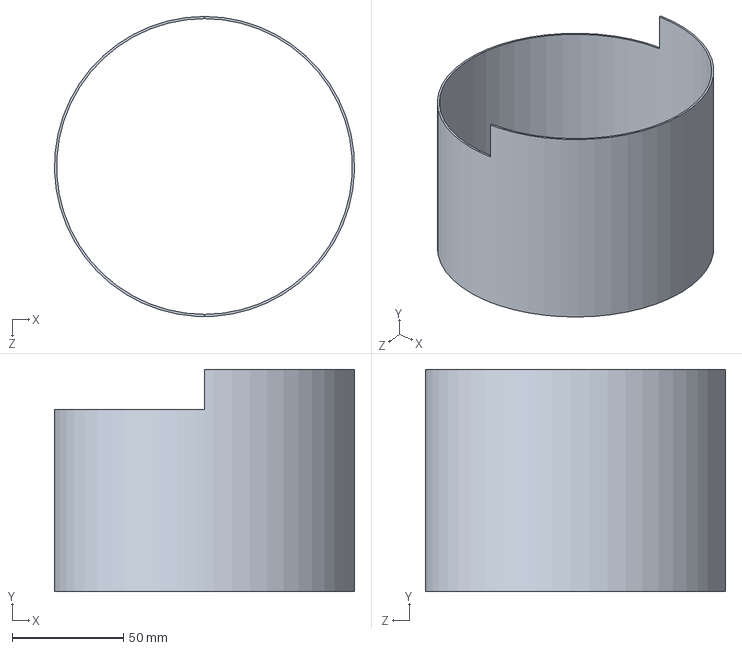
[picture p70: CAD file, 2019-12-19]
机械手3.9.4_Szk_even_more装配裕量/底座/壳子.SLDPRT
134.9 x 100.0 x 135.0 mm
