Logan-Shi/Teleop-Hand/机械手3.9.4_Szk_even_more装配裕量/底座/舵盘.SLDPRT

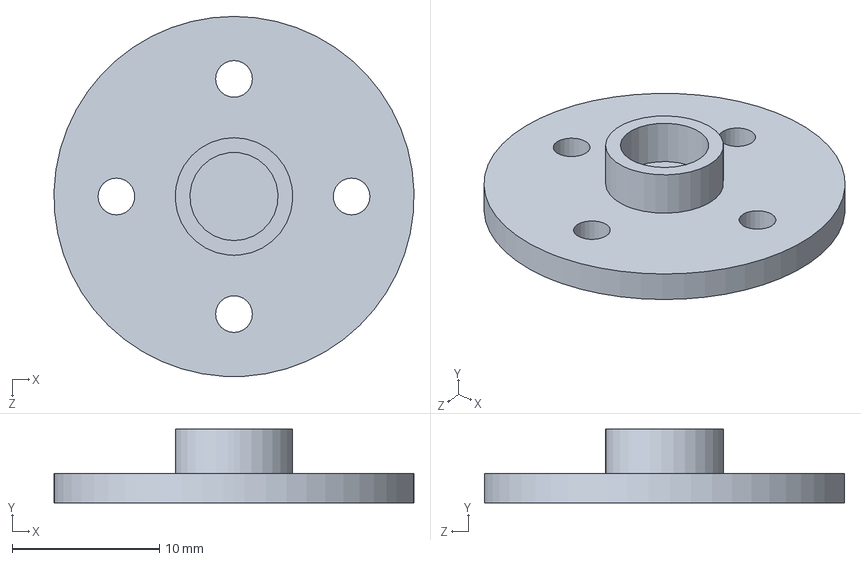
[picture p71: CAD file, 2019-12-19]
机械手3.9.4_Szk_even_more装配裕量/底座/舵盘.SLDPRT
24.5 x 5.00 x 24.5 mm
