Logan-Shi/Teleop-Hand/机械手3.9.4_Szk_even_more装配裕量/底座/齿轮臂.SLDPRT

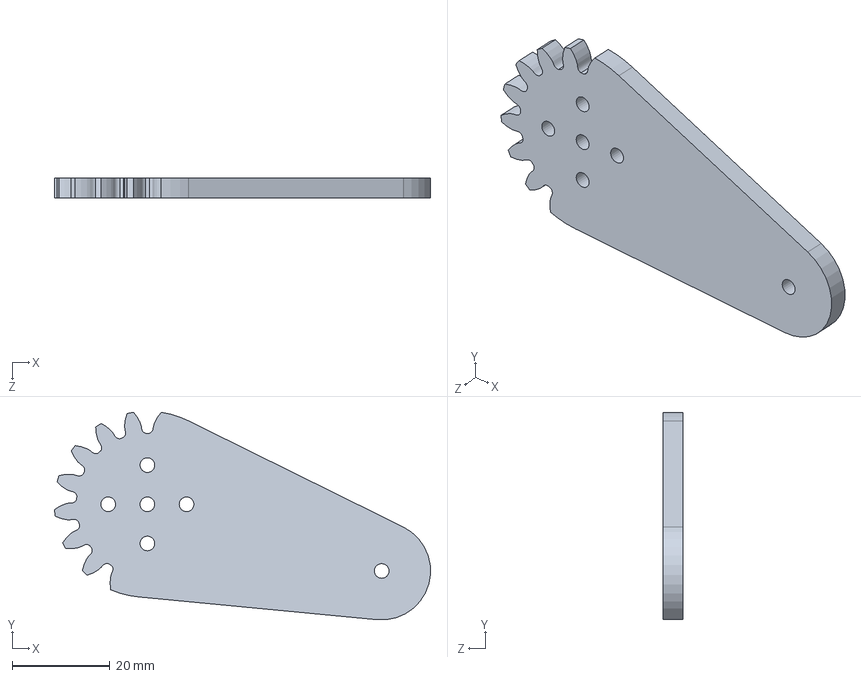
[picture p72: CAD file, 2019-12-19]
机械手3.9.4_Szk_even_more装配裕量/底座/齿轮臂.SLDPRT
76.8 x 42.4 x 4.00 mm
