Logan-Shi/Teleop-Hand/机械手3.9.4_Szk_even_more装配裕量/底座/舵机轴.SLDPRT

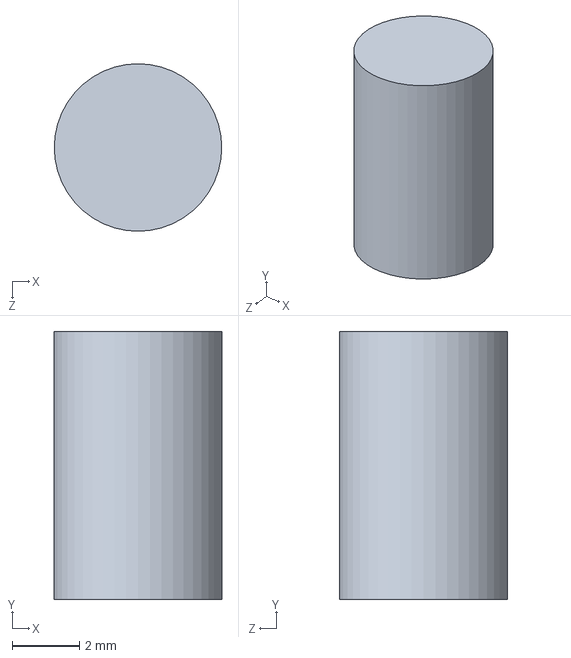
[picture p73: CAD file, 2019-12-19]
机械手3.9.4_Szk_even_more装配裕量/底座/舵机轴.SLDPRT
5.00 x 8.00 x 5.00 mm
