Logan-Shi/Teleop-Hand/机械手3.9.4_Szk_even_more装配裕量/底座/紧固环5-11-8.SLDPRT

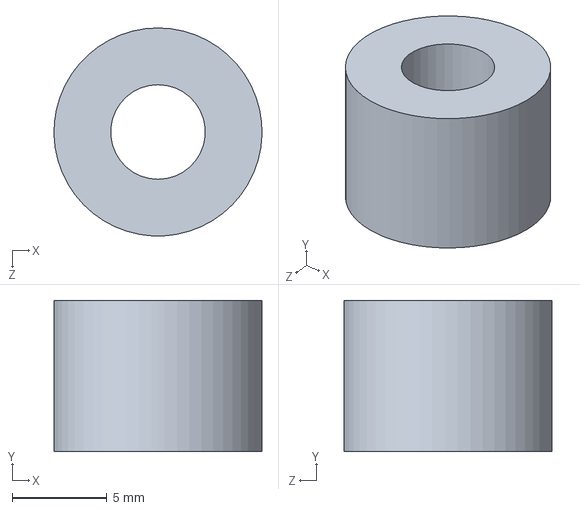
[picture p74: CAD file, 2019-12-19]
机械手3.9.4_Szk_even_more装配裕量/底座/紧固环5-11-8.SLDPRT
11.0 x 8.00 x 11.0 mm
