Logan-Shi/Teleop-Hand/机械手3.9.4_Szk_even_more装配裕量/底座/滑块.SLDPRT

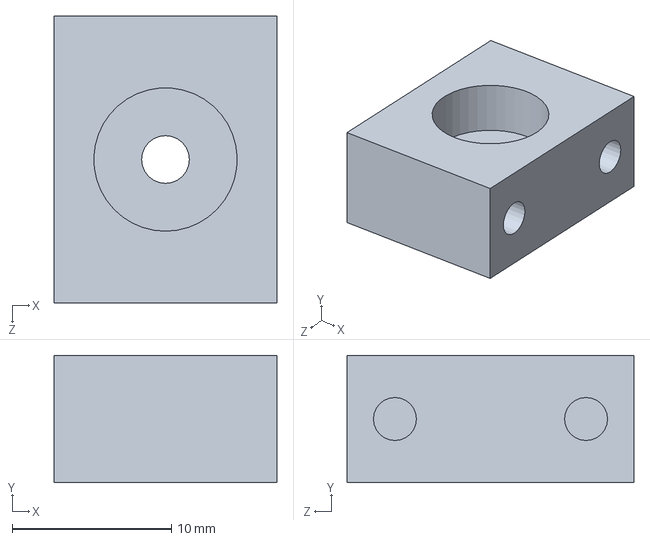
[picture p75: CAD file, 2019-12-19]
机械手3.9.4_Szk_even_more装配裕量/底座/滑块.SLDPRT
14.0 x 8.00 x 18.0 mm
