Logan-Shi/Teleop-Hand/机械手3.9.4_Szk_even_more装配裕量/底座/推力轴承3-8-4.SLDPRT

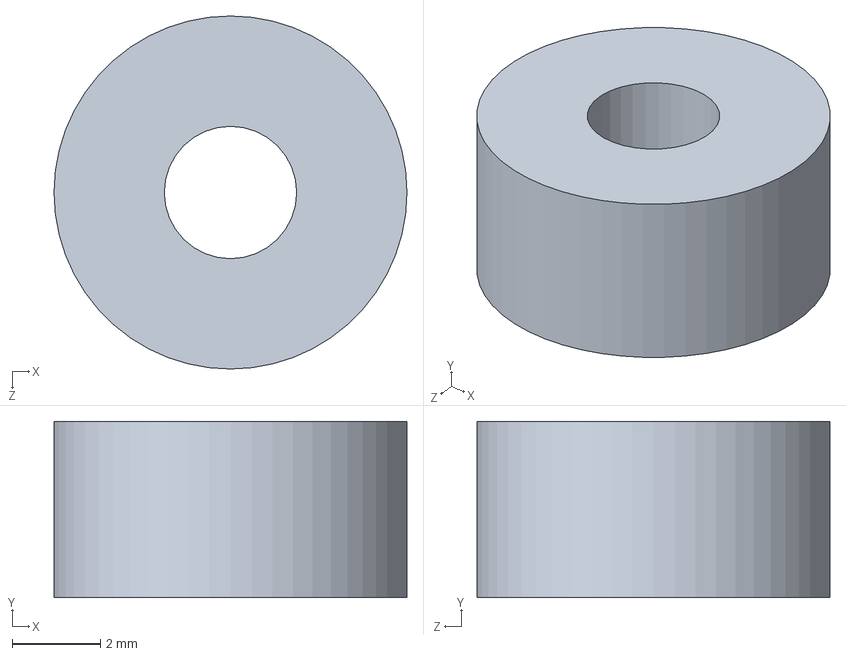
[picture p77: CAD file, 2019-12-19]
机械手3.9.4_Szk_even_more装配裕量/底座/推力轴承3-8-4.SLDPRT
8.00 x 4.00 x 8.00 mm
