Logan-Shi/Teleop-Hand/机械手3.9.4_Szk_even_more装配裕量/底座/铝柱16mm.SLDPRT

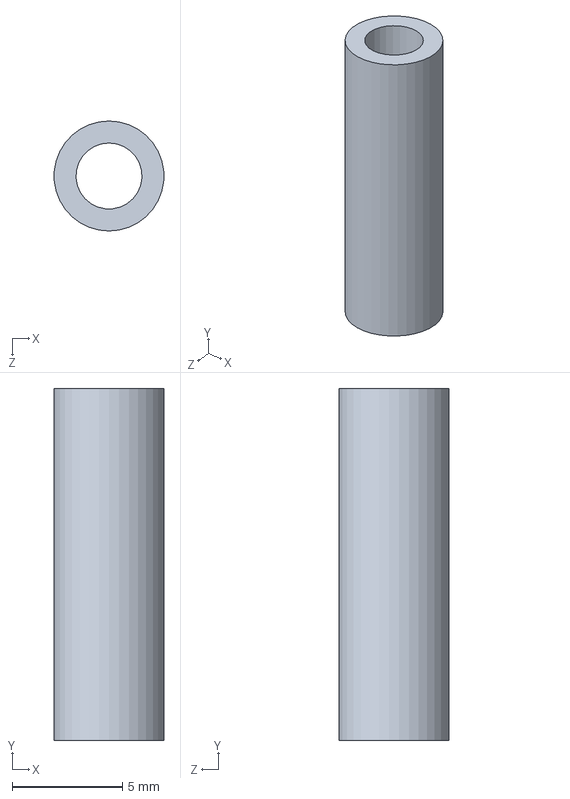
[picture p78: CAD file, 2019-12-19]
机械手3.9.4_Szk_even_more装配裕量/底座/铝柱16mm.SLDPRT
4.98 x 16.0 x 5.00 mm
