Logan-Shi/Teleop-Hand/机械手3.9.4_Szk_even_more装配裕量/底座/推力轴承7-17-6.SLDPRT

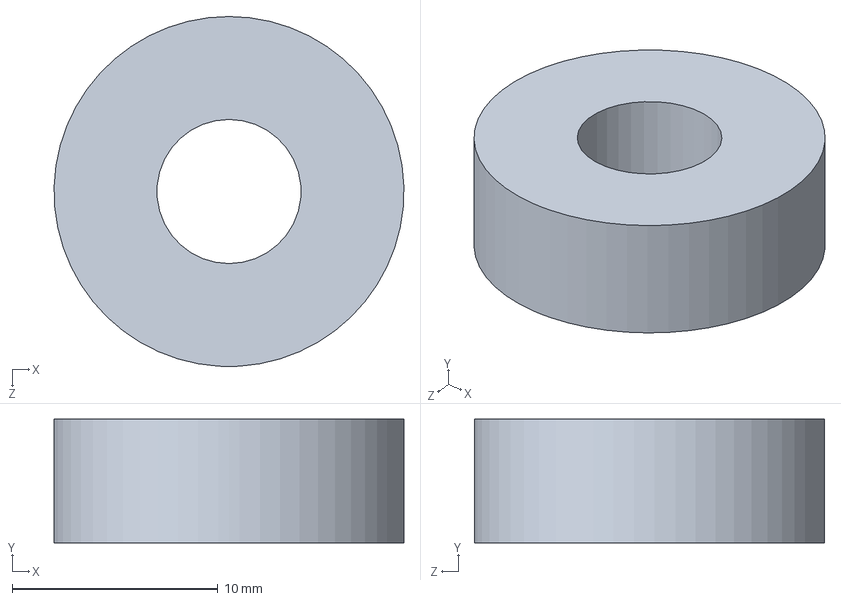
[picture p80: CAD file, 2019-12-19]
机械手3.9.4_Szk_even_more装配裕量/底座/推力轴承7-17-6.SLDPRT
17.0 x 6.00 x 17.0 mm
