Logan-Shi/Teleop-Hand/机械手3.9.4_Szk_even_more装配裕量/底座/滑杆.SLDPRT

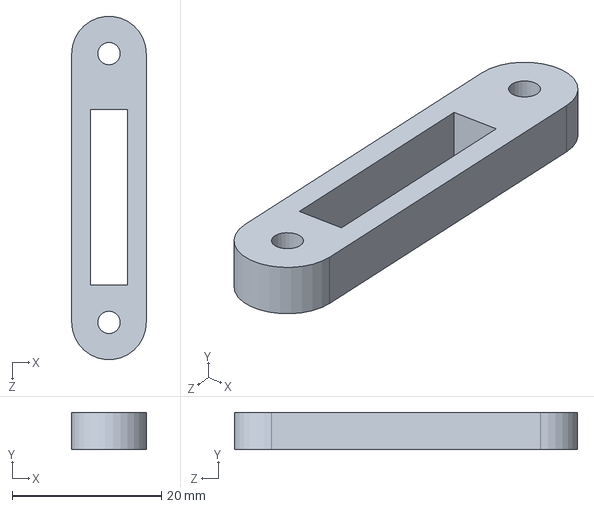
[picture p81: CAD file, 2019-12-19]
机械手3.9.4_Szk_even_more装配裕量/底座/滑杆.SLDPRT
10.0 x 5.00 x 45.9 mm
