Logan-Shi/Teleop-Hand/机械手3.9.4_Szk_even_more装配裕量/底座/圆形底座.SLDPRT

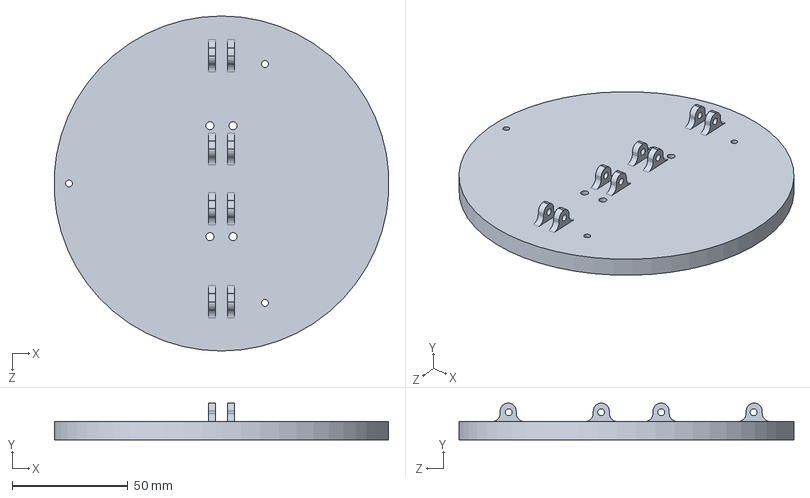
[picture p82: CAD file, 2019-12-19]
机械手3.9.4_Szk_even_more装配裕量/底座/圆形底座.SLDPRT
144.8 x 16.0 x 145.0 mm
