Logan-Shi/Teleop-Hand/(list of files, cad)

Other CAD files:
机械手3.9.4_Szk_even_more装配裕量/手指2.1/打印件/根指节.STL
机械手3.9.4_Szk_even_more装配裕量/走线装置/b3_t.SLDPRT
机械手3.9.4_Szk_even_more装配裕量/手指2.1/尾指节.SLDPRT
机械手3.9.4_Szk_even_more装配裕量/底座/草图.SLDPRT
机械手3.9.4_Szk_even_more装配裕量/底座/轴承.SLDPRT
机械手3.9.4_Szk_even_more装配裕量/底座/3434T31 - nylon pulley.SLDPRT
机械手3.9.4_Szk_even_more装配裕量/底座/97395A435 D1-8 L3-8.SLDPRT
