Logan-Shi/Teleop-Hand/keil_project/Src/usart.c

/**
  ******************************************************************************
  * File Name          : USART.c
  * Description        : This file provides code for the configuration
  *                      of the USART instances.
  ******************************************************************************
  ** This notice applies to any and all portions of this file
  * that are not between comment pairs USER CODE BEGIN and
  * USER CODE END. Other portions of this file, whether 
  * inserted by the user or by software development tools
  * are owned by their respective copyright owners.
  *
  * COPYRIGHT(c) 2018 STMicroelectronics
  *
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
  ******************************************************************************
  */

/* Includes ------------------------------------------------------------------*/
#include "usart.h"

#include "gpio.h"
#include "dma.h"

/* USER CODE BEGIN 0 */

#include "Remote_Control.h"

uint8_t UART_Buffer[100];
/* USER CODE END 0 */

UART_HandleTypeDef huart1;
UART_HandleTypeDef huart6;
DMA_HandleTypeDef hdma_usart1_rx;

/* USART1 init function */


void MX_USART1_UART_Init(void)
{

  huart1.Instance = USART1;
  huart1.Init.BaudRate = 100000;
  huart1.Init.WordLength = UART_WORDLENGTH_8B;
  huart1.Init.StopBits = UART_STOPBITS_1;
  huart1.Init.Parity = UART_PARITY_EVEN;
  huart1.Init.Mode = UART_MODE_TX_RX;
  huart1.Init.HwFlowCtl = UART_HWCONTROL_NONE;
  huart1.Init.OverSampling = UART_OVERSAMPLING_16;
  if (HAL_UART_Init(&huart1) != HAL_OK)
  {
    _Error_Handler(__FILE__, __LINE__);
  }

}



//HAL_UART_Transmit(&huart6,buf,sizeof(buf))
//HAL_UART_Transmit(&huart6,buf,size,time_out)
void MX_USART6_UART_Init(void)
{

  huart6.Instance = USART6;
  huart6.Init.BaudRate = 115200;
  huart6.Init.WordLength = UART_WORDLENGTH_8B;
  huart6.Init.StopBits = UART_STOPBITS_1;
  huart6.Init.Parity = UART_PARITY_NONE;
  huart6.Init.Mode = UART_MODE_TX_RX;
  huart6.Init.HwFlowCtl = UART_HWCONTROL_NONE;
  huart6.Init.OverSampling = UART_OVERSAMPLING_16;
  if (HAL_UART_Init(&huart6) != HAL_OK)
  {
    _Error_Handler(__FILE__, __LINE__);
  }

}
void HAL_UART_MspInit(UART_HandleTypeDef* uartHandle)
{

  GPIO_InitTypeDef GPIO_InitStruct = {0};
  if(uartHandle->Instance==USART1)
  {
    /* USART1 clock enable */
    __HAL_RCC_USART1_CLK_ENABLE();
  
    /**USART1 GPIO Configuration    
    PB7     ------> USART1_RX
    PB6     ------> USART1_TX 
    */
    GPIO_InitStruct.Pin = GPIO_PIN_7|GPIO_PIN_6;
    GPIO_InitStruct.Mode = GPIO_MODE_AF_PP;
    GPIO_InitStruct.Pull = GPIO_PULLUP;
    GPIO_InitStruct.Speed = GPIO_SPEED_FREQ_VERY_HIGH;
    GPIO_InitStruct.Alternate = GPIO_AF7_USART1;
    HAL_GPIO_Init(GPIOB, &GPIO_InitStruct);

    /* USART1 DMA Init */
    /* USART1_RX Init */
    hdma_usart1_rx.Instance = DMA2_Stream2;
    hdma_usart1_rx.Init.Channel = DMA_CHANNEL_4;
    hdma_usart1_rx.Init.Direction = DMA_PERIPH_TO_MEMORY;
    hdma_usart1_rx.Init.PeriphInc = DMA_PINC_DISABLE;
    hdma_usart1_rx.Init.MemInc = DMA_MINC_ENABLE;
    hdma_usart1_rx.Init.PeriphDataAlignment = DMA_PDATAALIGN_BYTE;
    hdma_usart1_rx.Init.MemDataAlignment = DMA_MDATAALIGN_BYTE;
    hdma_usart1_rx.Init.Mode = DMA_NORMAL;
    hdma_usart1_rx.Init.Priority = DMA_PRIORITY_LOW;
    hdma_usart1_rx.Init.FIFOMode = DMA_FIFOMODE_DISABLE;
    if (HAL_DMA_Init(&hdma_usart1_rx) != HAL_OK)
    {
      _Error_Handler(__FILE__, __LINE__);
    }

    __HAL_LINKDMA(uartHandle,hdmarx,hdma_usart1_rx);

    /* USART1 interrupt Init */
    HAL_NVIC_SetPriority(USART1_IRQn, 0, 0);
    HAL_NVIC_EnableIRQ(USART1_IRQn);
  }
	else if(uartHandle->Instance==USART6)
	{
    /* Peripheral clock enable */
    __HAL_RCC_USART6_CLK_ENABLE();
  
    __HAL_RCC_GPIOG_CLK_ENABLE();
    /**USART6 GPIO Configuration    
    PG14     ------> USART6_TX
    PG9     ------> USART6_RX 
    */
    GPIO_InitStruct.Pin = GPIO_PIN_14|GPIO_PIN_9;
    GPIO_InitStruct.Mode = GPIO_MODE_AF_PP;
    GPIO_InitStruct.Pull = GPIO_PULLUP;
    GPIO_InitStruct.Speed = GPIO_SPEED_FREQ_VERY_HIGH;
    GPIO_InitStruct.Alternate = GPIO_AF8_USART6;
    HAL_GPIO_Init(GPIOG, &GPIO_InitStruct);

    /* USART6 interrupt Init */
    HAL_NVIC_SetPriority(USART6_IRQn, 0, 0);
    HAL_NVIC_EnableIRQ(USART6_IRQn);
	}
	
}

void HAL_UART_MspDeInit(UART_HandleTypeDef* uartHandle)
{

  if(uartHandle->Instance==USART1)
  {
    /* Peripheral clock disable */
    __HAL_RCC_USART1_CLK_DISABLE();
  
    /**USART1 GPIO Configuration    
    PB7     ------> USART1_RX
    PB6     ------> USART1_TX 
    */
    HAL_GPIO_DeInit(GPIOB, GPIO_PIN_7|GPIO_PIN_6);

    /* USART1 DMA DeInit */
    HAL_DMA_DeInit(uartHandle->hdmarx);

    /* USART1 interrupt Deinit */
    HAL_NVIC_DisableIRQ(USART1_IRQn);
  }
	else if(uartHandle->Instance==USART6)
	{
    /* Peripheral clock disable */
    __HAL_RCC_USART6_CLK_DISABLE();
  
    /**USART1 GPIO Configuration    
    PB7     ------> USART1_RX
    PB6     ------> USART1_TX 
    */
    HAL_GPIO_DeInit(GPIOB, GPIO_PIN_14|GPIO_PIN_9);

    /* USART1 DMA DeInit */
    HAL_DMA_DeInit(uartHandle->hdmarx);

    /* USART1 interrupt Deinit */
    HAL_NVIC_DisableIRQ(USART6_IRQn);
	}
	
} 

/* USER CODE BEGIN 1 */
/**e
  * @brief  配置串口没有DMA中断的接收
	*					串口使用了空闲中断，所以这里没有必要再开启DMA中断，由于HAL库中所带的UART_Receive_DMA函数默认开启了DMA中断，
	*					这里要自己实现一个没有中断的DMA接收函数。
  *         
  * @param  
  * @retval HAL status
  */
HAL_StatusTypeDef UART_Receive_DMA_NoIT(UART_HandleTypeDef *huart, uint8_t *pData, uint16_t Size)
{
 uint32_t *tmp;
  
  /* Check that a Rx process is not already ongoing */
  if(huart->RxState == HAL_UART_STATE_READY) 
  {
    if((pData == NULL) || (Size == 0U))
    {
      return HAL_ERROR;
    }

    /* Process Locked */
    __HAL_LOCK(huart);

    huart->pRxBuffPtr = pData;
    huart->RxXferSize = Size;

    huart->ErrorCode = HAL_UART_ERROR_NONE;
    huart->RxState = HAL_UART_STATE_BUSY_RX;
    /* Set the DMA abort callback */
    huart->hdmarx->XferAbortCallback = NULL;

    /* Enable the DMA channel */
    tmp = (uint32_t*)&pData;
    HAL_DMA_Start(huart->hdmarx, (uint32_t)&huart->Instance->DR, *(uint32_t*)tmp, Size);

    /* Clear the Overrun flag just before enabling the DMA Rx request: can be mandatory for the second transfer */
    __HAL_UART_CLEAR_OREFLAG(huart);

    /* Process Unlocked */
    __HAL_UNLOCK(huart);

    /* Enable the UART Parity Error Interrupt */
    SET_BIT(huart->Instance->CR1, USART_CR1_PEIE);

    /* Enable the UART Error Interrupt: (Frame error, noise error, overrun error) */
    SET_BIT(huart->Instance->CR3, USART_CR3_EIE);

    /* Enable the DMA transfer for the receiver request by setting the DMAR bit 
    in the UART CR3 register */
    SET_BIT(huart->Instance->CR3, USART_CR3_DMAR);

    return HAL_OK;
  }
  else
  {
    return HAL_BUSY;
  }
}




HAL_StatusTypeDef HAL_UART_Receive_IT_IDLE(UART_HandleTypeDef *huart, uint8_t *pData, uint16_t Size){

	
		__HAL_UART_ENABLE_IT(huart, UART_IT_IDLE);//开启串口空闲中断
	
		return UART_Receive_DMA_NoIT(huart,pData,Size);//启动没有DMA中断的DMA接收函数


}


void HAL_UART_IDLE_IRQHandler(UART_HandleTypeDef *huart)
{
		
		uint32_t DMA_FLAGS,tmp;
	
			
	if(__HAL_UART_GET_FLAG(huart, UART_FLAG_IDLE)){
			
		tmp = huart->Instance->SR;
		tmp = huart->Instance->DR;
		tmp++;  
		DMA_FLAGS = __HAL_DMA_GET_TC_FLAG_INDEX(huart->hdmarx);
		
		//??DMA
	  __HAL_DMA_DISABLE(huart->hdmarx);
		__HAL_DMA_CLEAR_FLAG(huart->hdmarx,DMA_FLAGS);
		
		huart->hdmarx->Instance->NDTR = huart->RxXferSize;
		__HAL_DMA_ENABLE(huart->hdmarx);
		
	}
		
	
	Callback_RC_Handle(&remote_control,huart->pRxBuffPtr);
	
}


/* USER CODE END 1 */

/**
  * @}
  */

/**
  * @}
  */

/************************ (C) COPYRIGHT STMicroelectronics *****END OF FILE****/
