Logan-Shi/Teleop-Hand/(commit log)

2019-10-14 Add files via upload
    Sample CAD files of Mechanical Hand
    [90480A003 2-56 nut.SLDPRT, 91253A106 4-40 L1-4 countersunk.SLDPRT, 91253A110 4-40 L1-2 countersunk.SLDPRT, 91290A012 M2 L5 socket.SLDPRT, 91292A003 M2 L3 socket.SLDPRT, 91292A012 M2.5 L8 socket.SLDPRT, 91772A266 2-56 L5-4 pan.SLDPRT, 92196A084 2-56 L3-4 socket.SLDPRT]
2019-12-19 pwm done
    [3434T31 - nylon pulley.SLDPRT, 90480A003 2-56 nut.SLDPRT, 91253A106 4-40 L1-4 countersunk.SLDPRT, 91253A110 4-40 L1-2 countersunk.SLDPRT, 91290A012 M2 L5 socket.SLDPRT, 91292A003 M2 L3 socket.SLDPRT, 91292A012 M2.5 L8 socket.SLDPRT, 91772A266 2-56 L5-4 pan.SLDPRT]
